6thSense-dev/mocap-glove/control-panel/README.txt

Run Start-control-panel.command to open localhost:8775.
Supports bench 0.1 and diagnostics 0.2. New tests require diagnostics 0.2.
Read ../START-HERE.txt before powered coil tests. No calibrated positions are produced.
