6thSense-dev/mocap-glove/hardware/pcb/v6/hand-hub/views/3d-bottom.png

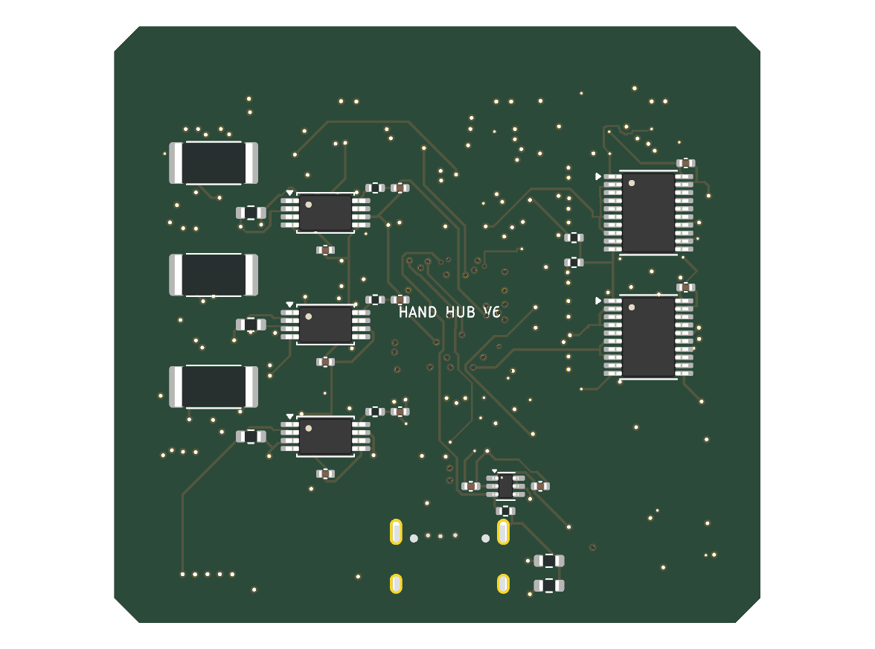
hardware/pcb/v6/hand-hub/views/3d-bottom.png
