6thSense-dev/mocap-glove/hardware/pcb/v6/source-carrier/views/3d-bottom.png

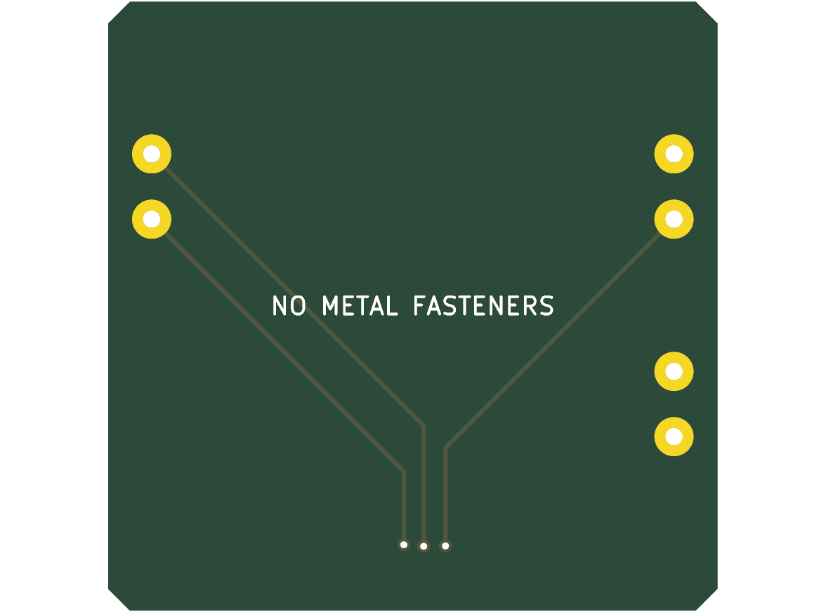
hardware/pcb/v6/source-carrier/views/3d-bottom.png
