6thSense-dev/mocap-glove/hardware/pcb/v6/fingertip/fabrication/BOM.csv

Comment | Designator | Footprint | LCSC Part #
ADS131M04IPWR | U1 | TSSOP-20_4.4x6.5mm_P0.65mm | C2862562
49.9 | R1,R10,R2,R5,R6,R9 | R_0402_1005Metric | C87044
10k | R11,R12,R3,R4,R7,R8 | R_0402_1005Metric | C25744
1n C0G | C1,C2,C3 | C_0402_1005Metric | C307441
10 | R13 | R_0402_1005Metric | C25077
1u | C4,C6 | C_0402_1005Metric | C52923
100n | C5,C7 | C_0402_1005Metric | C1525
220n | C8 | C_0402_1005Metric | C16772
33 | R14,R15 | R_0402_1005Metric | C25105
100k | R16,R17 | R_0402_1005Metric | C25741
4.7u | C9 | C_0402_1005Metric | C23733
