6thSense-dev/mocap-glove/hardware/pcb/v6/hand-hub/fabrication/BOM.csv

Comment | Designator | Footprint | LCSC Part #
TYPE-C-31-M-12 | J6 | USB_C_HRO_Envelope | C165948
5.1k | R1,R2 | R_0603_1608Metric | C23186
USBLC6-2SC6 | U2 | SOT-23-6 | C7519
TLV75533PDBVR | U3 | SOT-23-5 | C404027
1u | C1 | C_0603_1608Metric | C15849
4.7u | C2 | C_0603_1608Metric | C19666
0 | R3,R4 | R_0603_1608Metric | C21189
STM32G474RET6 | U1 | LQFP-64_10x10mm_P0.5mm | C521608
100n | C10,C11,C12,C13,C14,C15,C16,C19,C20,C23,C24,C27,C28,C29,C3,C4,C5,C6,C9 | C_0402_1005Metric | C1525
4.7u | C7 | C_0402_1005Metric | C23733
10 | R5 | R_0402_1005Metric | C25077
1u | C17,C21,C25,C8 | C_0402_1005Metric | C52923
10k | R52,R6 | R_0402_1005Metric | C25744
PH1.27-02-03PWS | J7 | XUNPU_PH127_2x03_SMD | C41360875
3N08192G33YC | Y1 | SJK_3N_3225 | C252332
33 | R25,R28,R31,R34,R37,R7 | R_0402_1005Metric | C25105
120 | R10,R11,R12,R13,R14,R15,R16,R17,R18,R19,R20,R21,R22,R8,R9 | R_0402_1005Metric | C114758
SN74LVC244APWR | U4,U5 | TSSOP-20_4.4x6.5mm_P0.65mm | C7668
FH12-12S-0.5SH(55) | J1,J2,J3,J4,J5 | Hirose_FH12-12S-0.5SH_1x12-1MP_P0.50mm_Horizontal | C88360
47 | R23,R24,R26,R27,R29,R30,R32,R33,R35,R36 | R_0402_1005Metric | C25118
100k | R38,R39,R51,R53 | R_0402_1005Metric | C25741
BMI323 | U6 | Bosch_LGA-14_3x2.5mm_P0.5mm | C5368700
4.7k | R40,R41 | R_0402_1005Metric | C25900
DRV8837DSGR | U7,U8,U9 | WSON-8-1EP_2x2mm_P0.5mm_EP0.9x1.6mm | C39159
FRR2512F47R0TS | R42,R45,R48 | R_2512_6332Metric | C49196864
RL0603FR-070R2L | R43,R46,R49 | R_0603_1608Metric | C723543
INA240A1PWR | U10,U11,U12 | TSSOP-8_4.4x3mm_P0.65mm | C93965
100 | R44,R47,R50 | R_0402_1005Metric | C25076
1nF C0G 50V | C18,C22,C26 | C_0402_1005Metric | C307441
BM06B-SRSS-TB(LF)(SN) | J9 | JST_SH_BM06B-SRSS-TB_1x06-1MP_P1.00mm_Vertical | C160392
B3U-1000P | SW1,SW2 | SW_SPST_B3U-1000P | C231329
TPS22919DCKR | U14 | SOT-363_SC-70-6 | C2149796
