6thSense-dev/mocap-glove/hardware/pcb/v6/source-carrier/fabrication/BOM.csv

Comment | Designator | Footprint | LCSC Part #
BM06B-SRSS-TB(LF)(SN) | J1 | JST_SH_BM06B-SRSS-TB_1x06-1MP_P1.00mm_Vertical | C160392
