6thSense-dev/mocap-glove/hardware/pcb/v6/fingertip/fingertip.kicad_pcb

## KiCad design hardware/pcb/v6/fingertip/fingertip.kicad_pcb (2026-11-04)

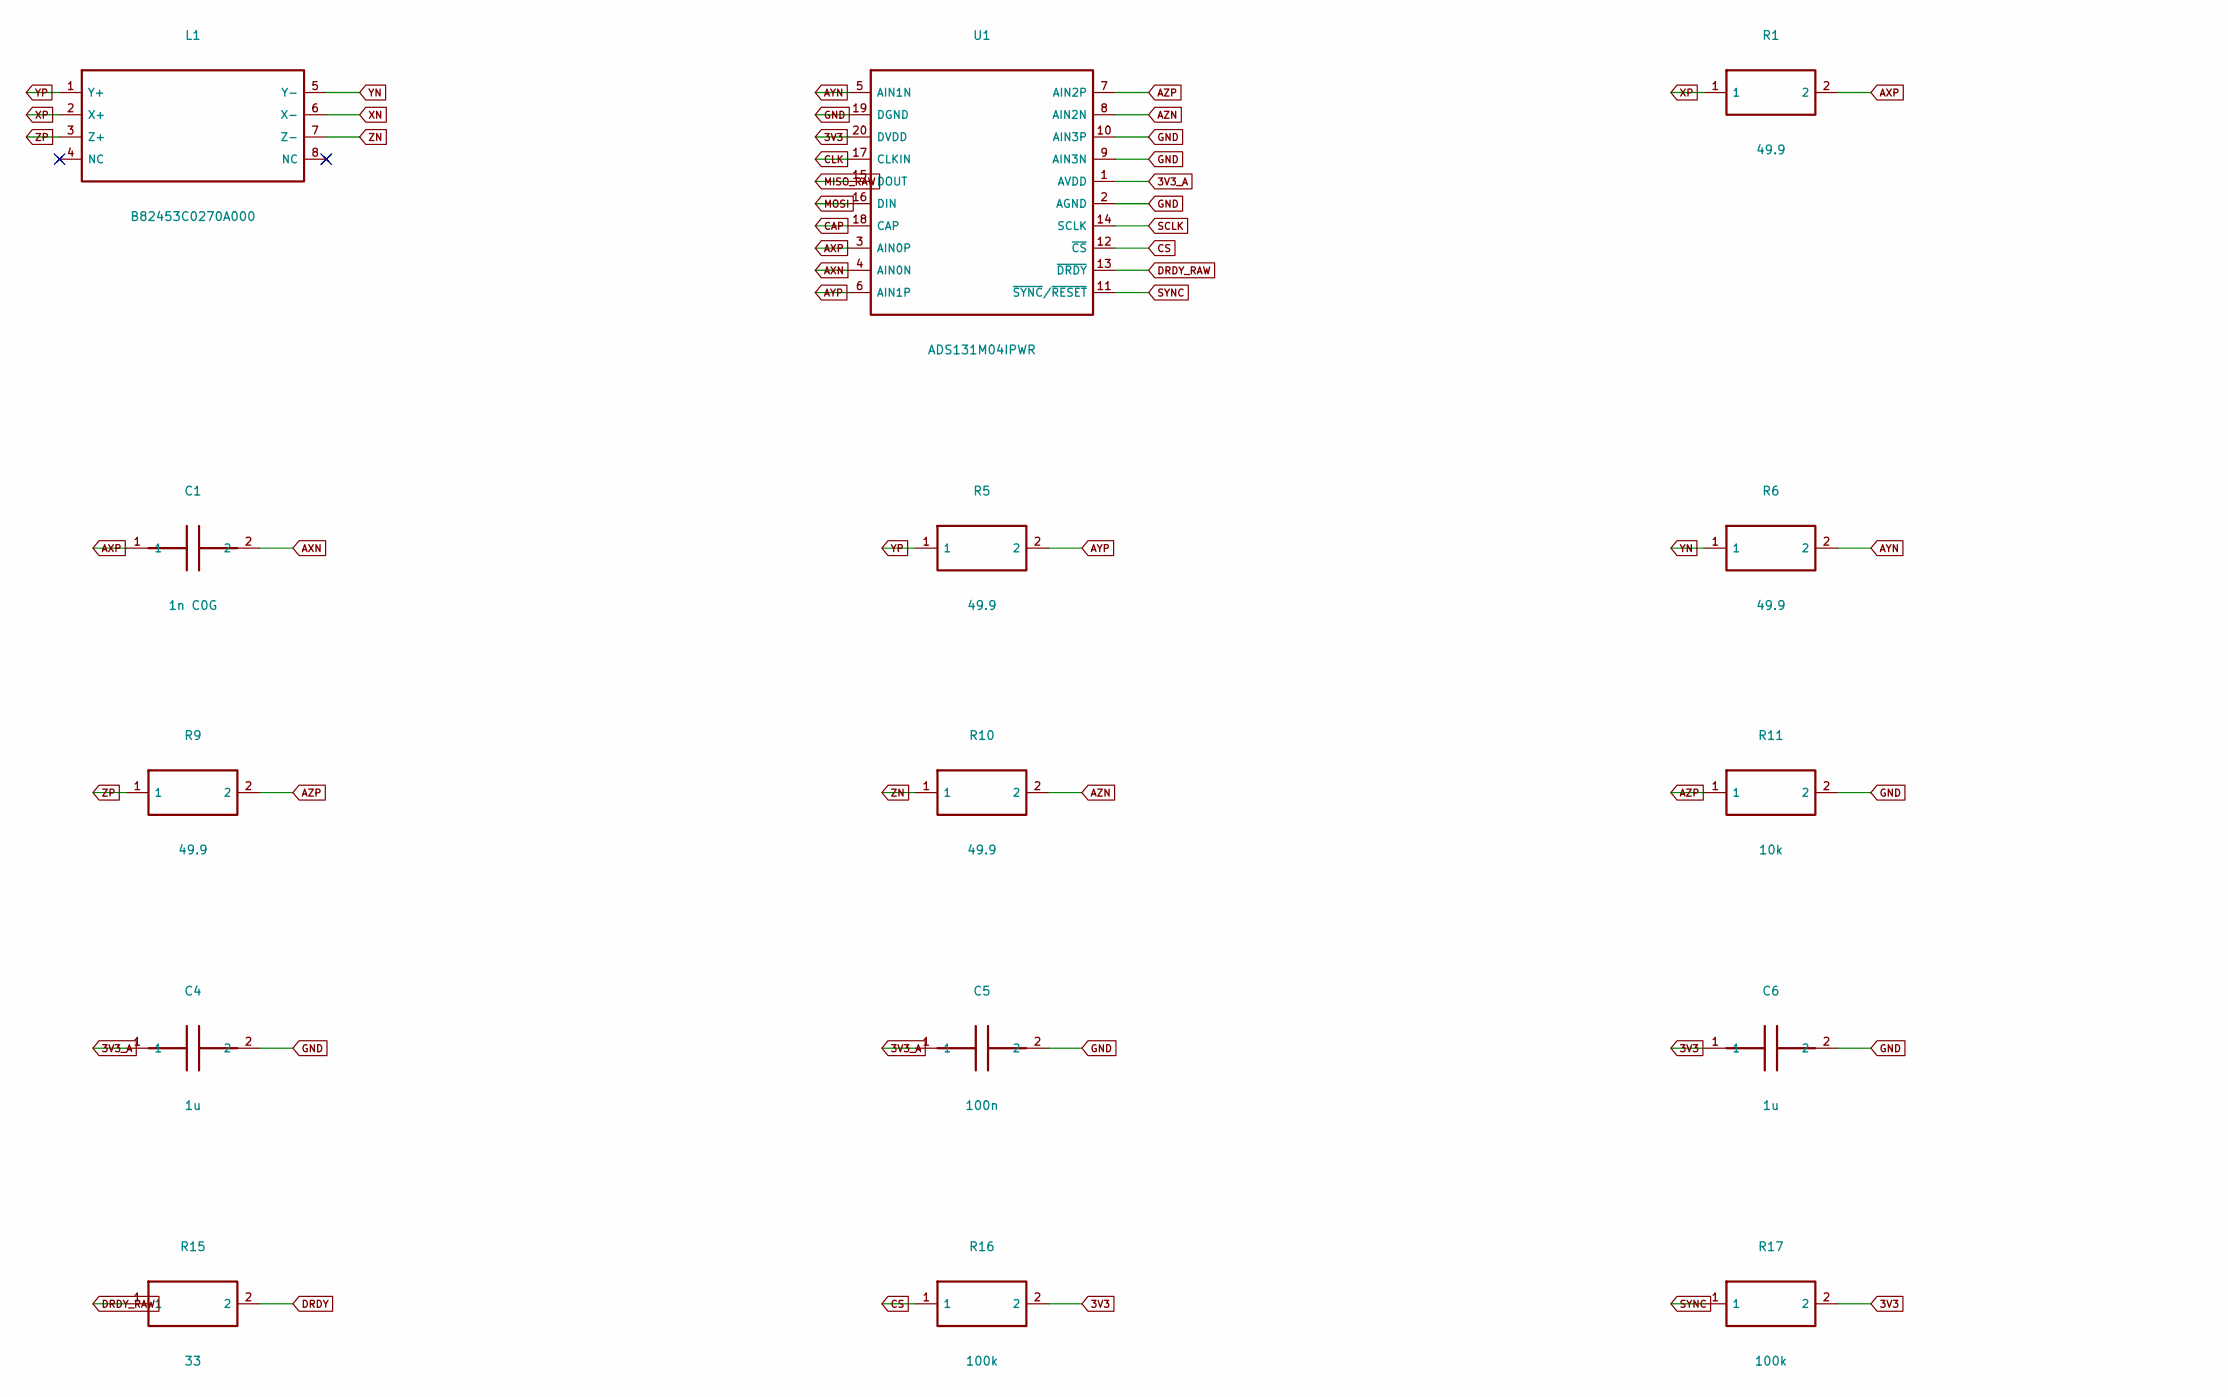
[picture p6: schematic sensor-and-adc.kicad_sch, fingertip - Sensor and ADC, part in row 1, column 1]

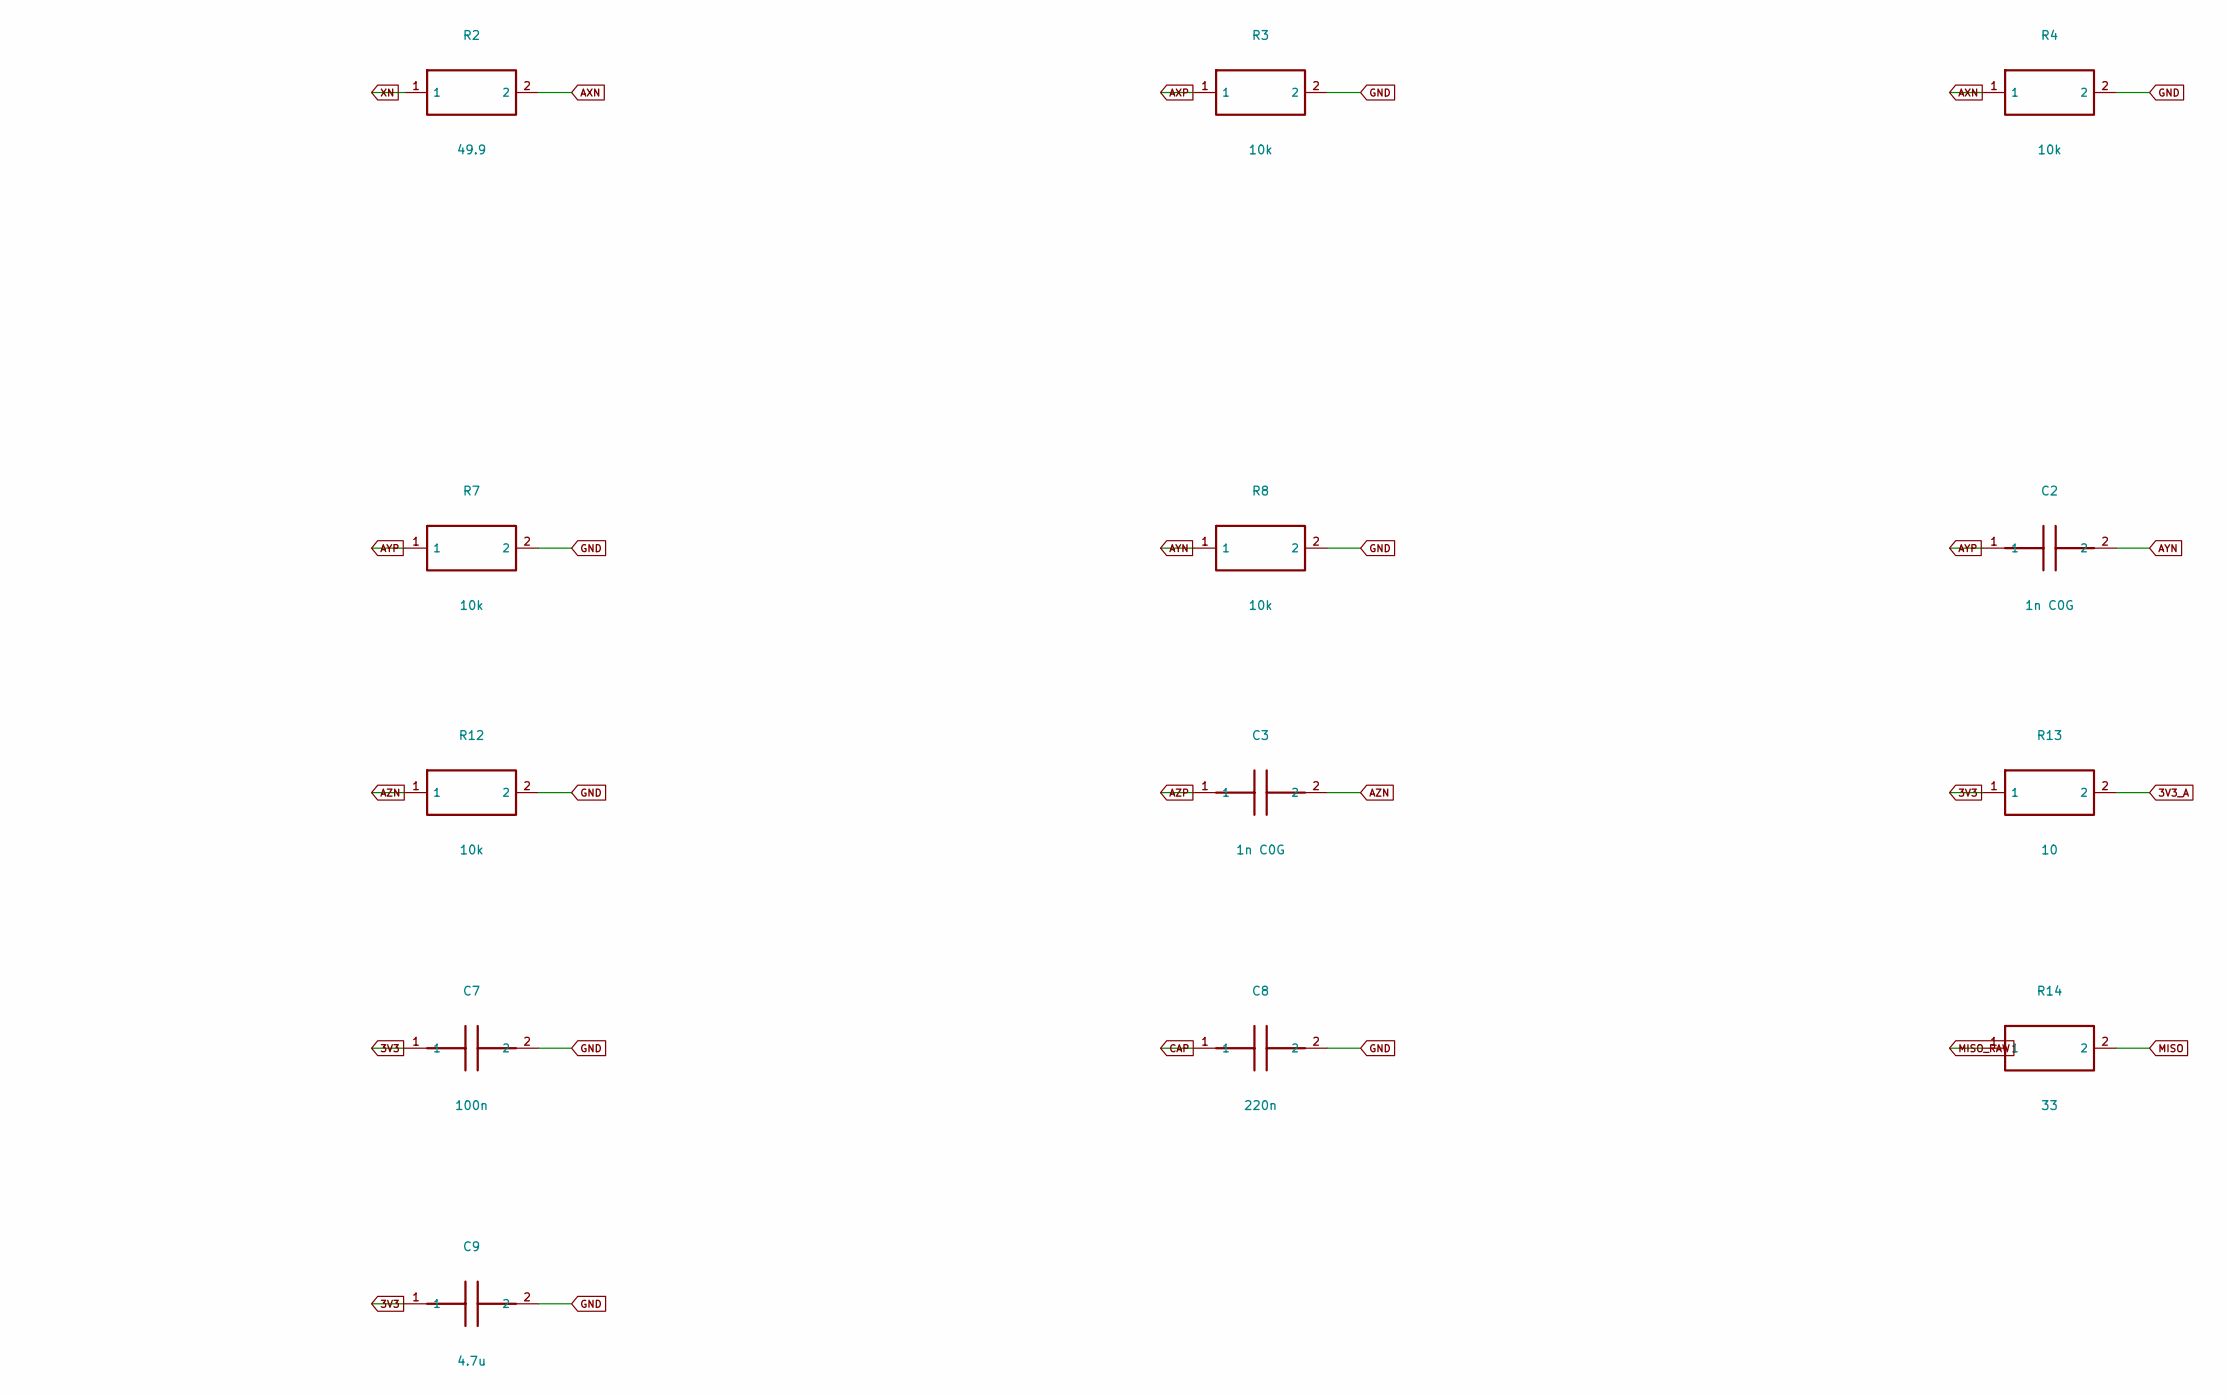
[picture p7: schematic sensor-and-adc.kicad_sch, fingertip - Sensor and ADC, part in row 1, column 2]

Parts:
C1, C2, C3: 1n C0G; C_0402_1005Metric; MPN 1n C0G
C4, C6: 1u; C_0402_1005Metric; MPN 1u
C5, C7: 100n; C_0402_1005Metric; MPN 100n
C8: 220n; C_0402_1005Metric; MPN 220n
C9: 4.7u; C_0402_1005Metric; MPN 4.7u
L1: B82453C0270A000; TDK_3D; MPN B82453C0270A000
R1, R2, R5, R6, R9, R10: 49.9; R_0402_1005Metric; MPN 49.9
R3, R4, R7, R8, R11, R12: 10k; R_0402_1005Metric; MPN 10k
R13: 10; R_0402_1005Metric; MPN 10
R14, R15: 33; R_0402_1005Metric; MPN 33
R16, R17: 100k; R_0402_1005Metric; MPN 100k
U1: ADS131M04IPWR; TSSOP-20_4.4x6.5mm_P0.65mm; MPN ADS131M04IPWR

Connections:
3V3: C6.1, C7.1, C9.1, R13.1, R16.2, R17.2, U1.20 (DVDD); also elsewhere on the board
3V3_A: C4.1, C5.1, R13.2, U1.1 (AVDD)
AXN: C1.2, R2.2, R4.1, U1.4 (AIN0N)
AXP: C1.1, R1.2, R3.1, U1.3 (AIN0P)
AYN: C2.2, R6.2, R8.1, U1.5 (AIN1N)
AYP: C2.1, R5.2, R7.1, U1.6 (AIN1P)
AZN: C3.2, R10.2, R12.1, U1.8 (AIN2N)
AZP: C3.1, R9.2, R11.1, U1.7 (AIN2P)
CAP: C8.1, U1.18 (CAP)
CLK: U1.17 (CLKIN); also elsewhere on the board
CS: R16.1, U1.12 (~CS); also elsewhere on the board
DRDY: R15.2; also elsewhere on the board
DRDY_RAW: R15.1, U1.13 (~DRDY)
GND: C4.2, C5.2, C6.2, C7.2, C8.2, C9.2, R3.2, R4.2, R7.2, R8.2, R11.2, R12.2, U1.2 (AGND), U1.9 (AIN3N), U1.10 (AIN3P), U1.19 (DGND); also elsewhere on the board
MISO: R14.2; also elsewhere on the board
MISO_RAW: R14.1, U1.15 (DOUT)
MOSI: U1.16 (DIN); also elsewhere on the board
SCLK: U1.14 (SCLK); also elsewhere on the board
SYNC: R17.1, U1.11 (~SYNC/~RESET); also elsewhere on the board
XN: L1.6 (X-), R2.1
XP: L1.2 (X+), R1.1
YN: L1.5 (Y-), R6.1
YP: L1.1 (Y+), R5.1
ZN: L1.7 (Z-), R10.1
ZP: L1.3 (Z+), R9.1

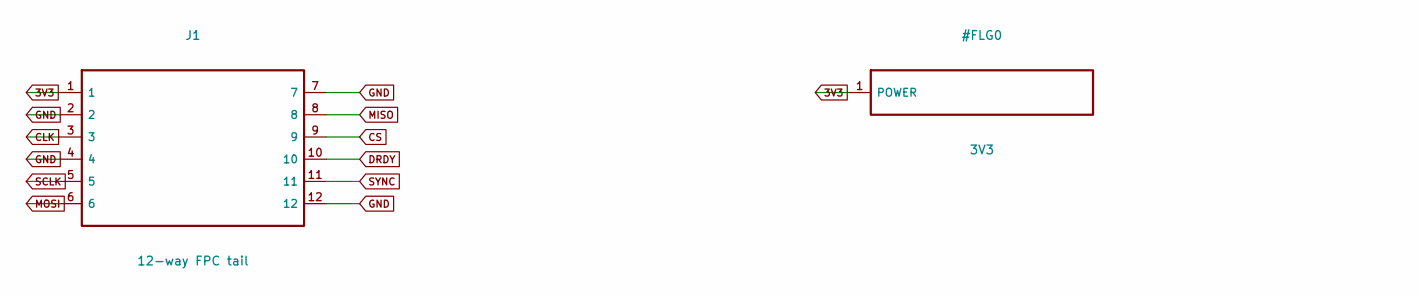
[picture p8: schematic power-and-data-flex.kicad_sch, fingertip - Power and data flex, part in row 1, column 1]

Parts:
J1: 12-way FPC tail; Tail12; MPN 12-way FPC tail

Connections:
3V3: J1.1; also elsewhere on the board
CLK: J1.3; also elsewhere on the board
CS: J1.9; also elsewhere on the board
DRDY: J1.10; also elsewhere on the board
GND: J1.2, J1.4, J1.7, J1.12; also elsewhere on the board
MISO: J1.8; also elsewhere on the board
MOSI: J1.6; also elsewhere on the board
SCLK: J1.5; also elsewhere on the board
SYNC: J1.11; also elsewhere on the board

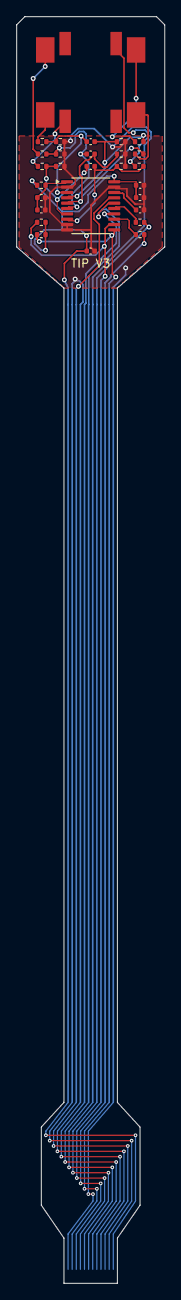
[picture p9: board fingertip.kicad_pcb from above]

Board: 2 copper layers, 18.0 x 154.0 mm, 29 parts (0 on the bottom side), 25 nets.
