6thSense-dev/mocap-glove/hardware/pcb/v6/hand-hub/hand-hub.kicad_pcb

## KiCad design hardware/pcb/v6/hand-hub/hand-hub.kicad_pcb (2026-11-04)

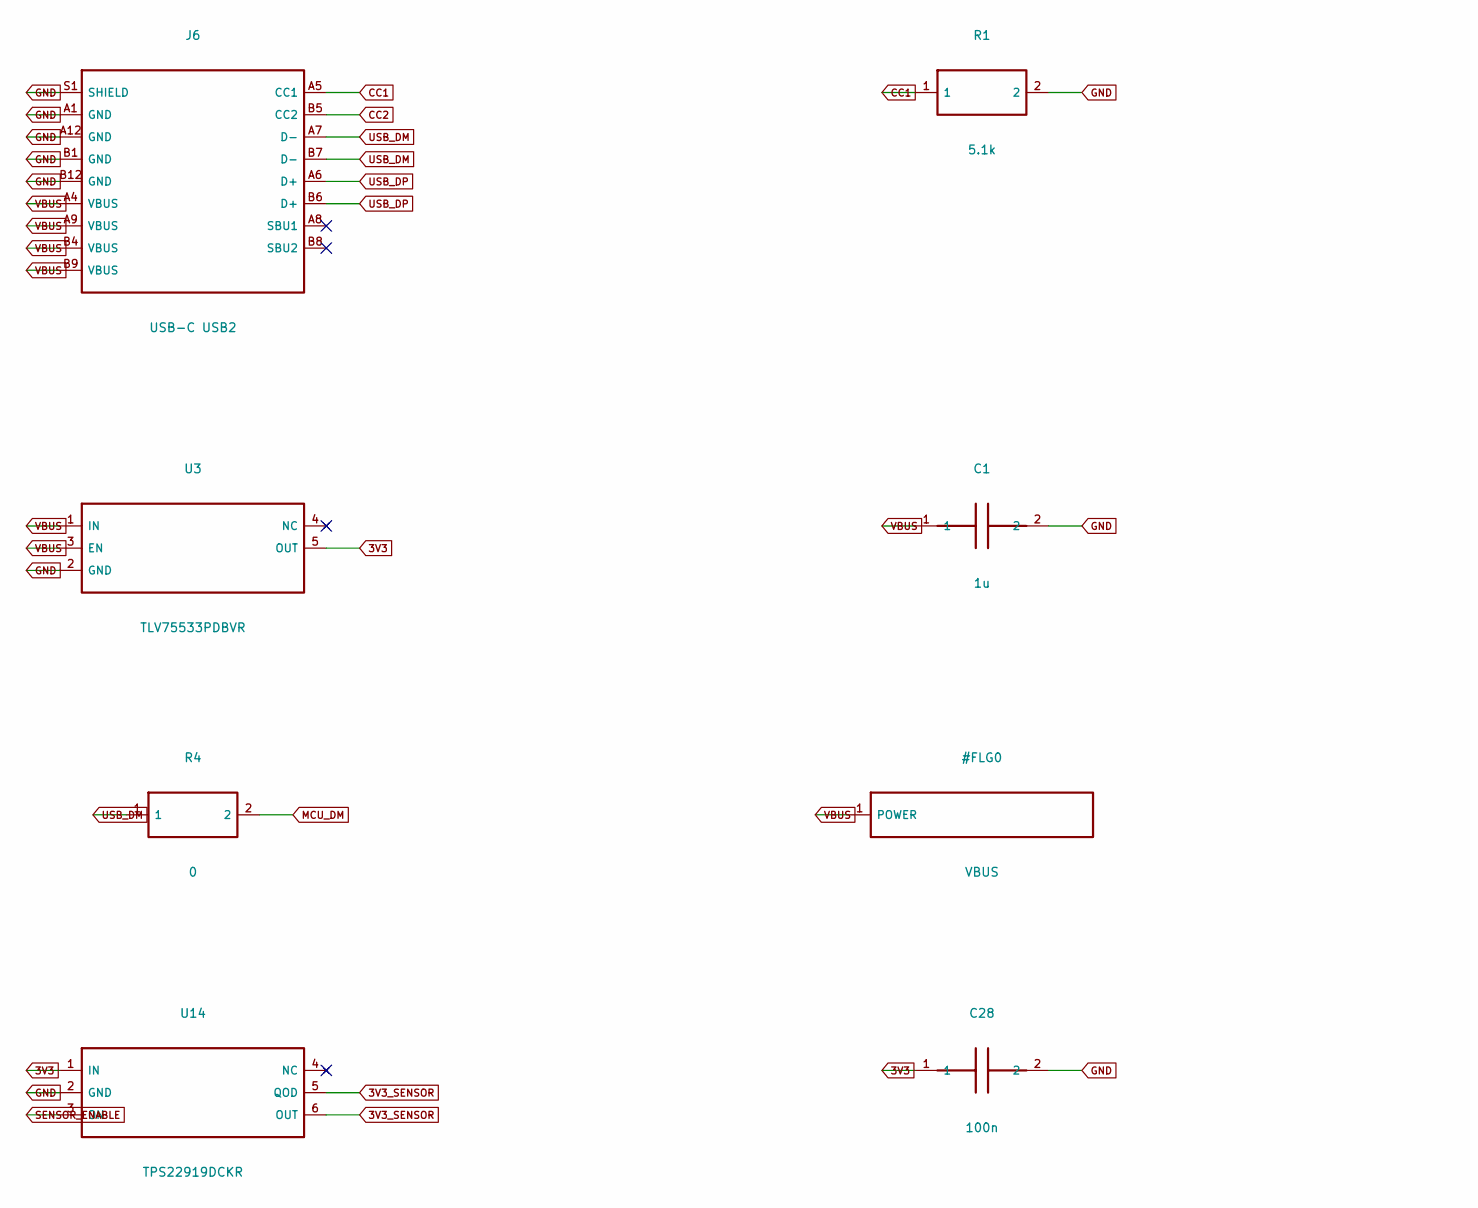
[picture p10: schematic power-usb.kicad_sch, hand-hub - Power USB, part in row 1, column 1]

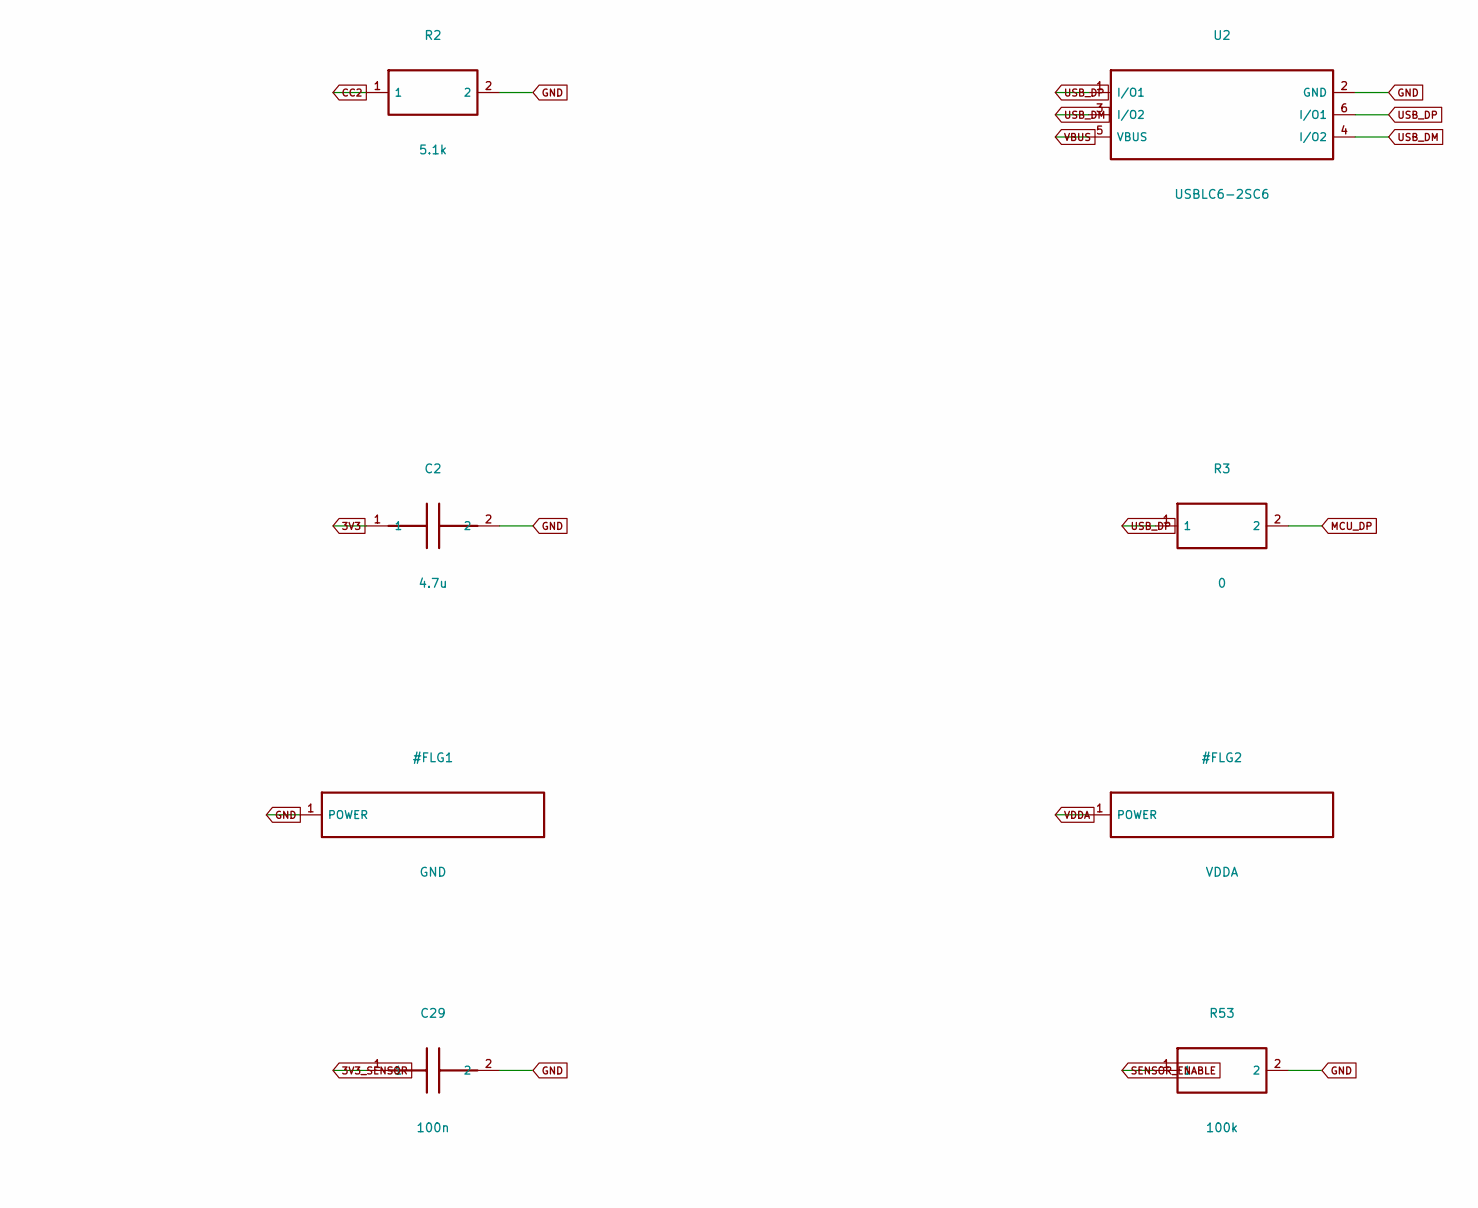
[picture p11: schematic power-usb.kicad_sch, hand-hub - Power USB, part in row 1, column 2]

Parts:
C1: 1u; C_0603_1608Metric; MPN 1u
C2: 4.7u; C_0603_1608Metric; MPN 4.7u
C28, C29: 100n; C_0402_1005Metric; MPN 100n
J6: USB-C USB2; USB_C_HRO_Envelope; MPN TYPE-C-31-M-12
R1, R2: 5.1k; R_0603_1608Metric; MPN 5.1k
R3, R4: 0; R_0603_1608Metric; MPN 0603WAF0000T5E
R53: 100k; R_0402_1005Metric; MPN 100k
U2: USBLC6-2SC6; SOT-23-6; MPN USBLC6-2SC6
U3: TLV75533PDBVR; SOT-23-5; MPN TLV75533PDBVR
U14: TPS22919DCKR; SOT-363_SC-70-6; MPN TPS22919DCKR

Connections:
3V3: C2.1, C28.1, U3.5 (OUT), U14.1 (IN); also elsewhere on the board
3V3_SENSOR: C29.1, U14.5 (QOD), U14.6 (OUT); also elsewhere on the board
CC1: J6.A5 (CC1), R1.1
CC2: J6.B5 (CC2), R2.1
GND: C1.2, C2.2, C28.2, C29.2, J6.A1 (GND), J6.A12 (GND), J6.B1 (GND), J6.B12 (GND), J6.S1 (SHIELD), R1.2, R2.2, R53.2, U2.2 (GND), U3.2 (GND), U14.2 (GND); also elsewhere on the board
MCU_DM: R4.2; also elsewhere on the board
MCU_DP: R3.2; also elsewhere on the board
SENSOR_ENABLE: R53.1, U14.3 (ON); also elsewhere on the board
USB_DM: J6.A7 (D-), J6.B7 (D-), R4.1, U2.3 (I/O2), U2.4 (I/O2)
USB_DP: J6.A6 (D+), J6.B6 (D+), R3.1, U2.1 (I/O1), U2.6 (I/O1)
VBUS: C1.1, J6.A4 (VBUS), J6.A9 (VBUS), J6.B4 (VBUS), J6.B9 (VBUS), U2.5 (VBUS), U3.1 (IN), U3.3 (EN); also elsewhere on the board

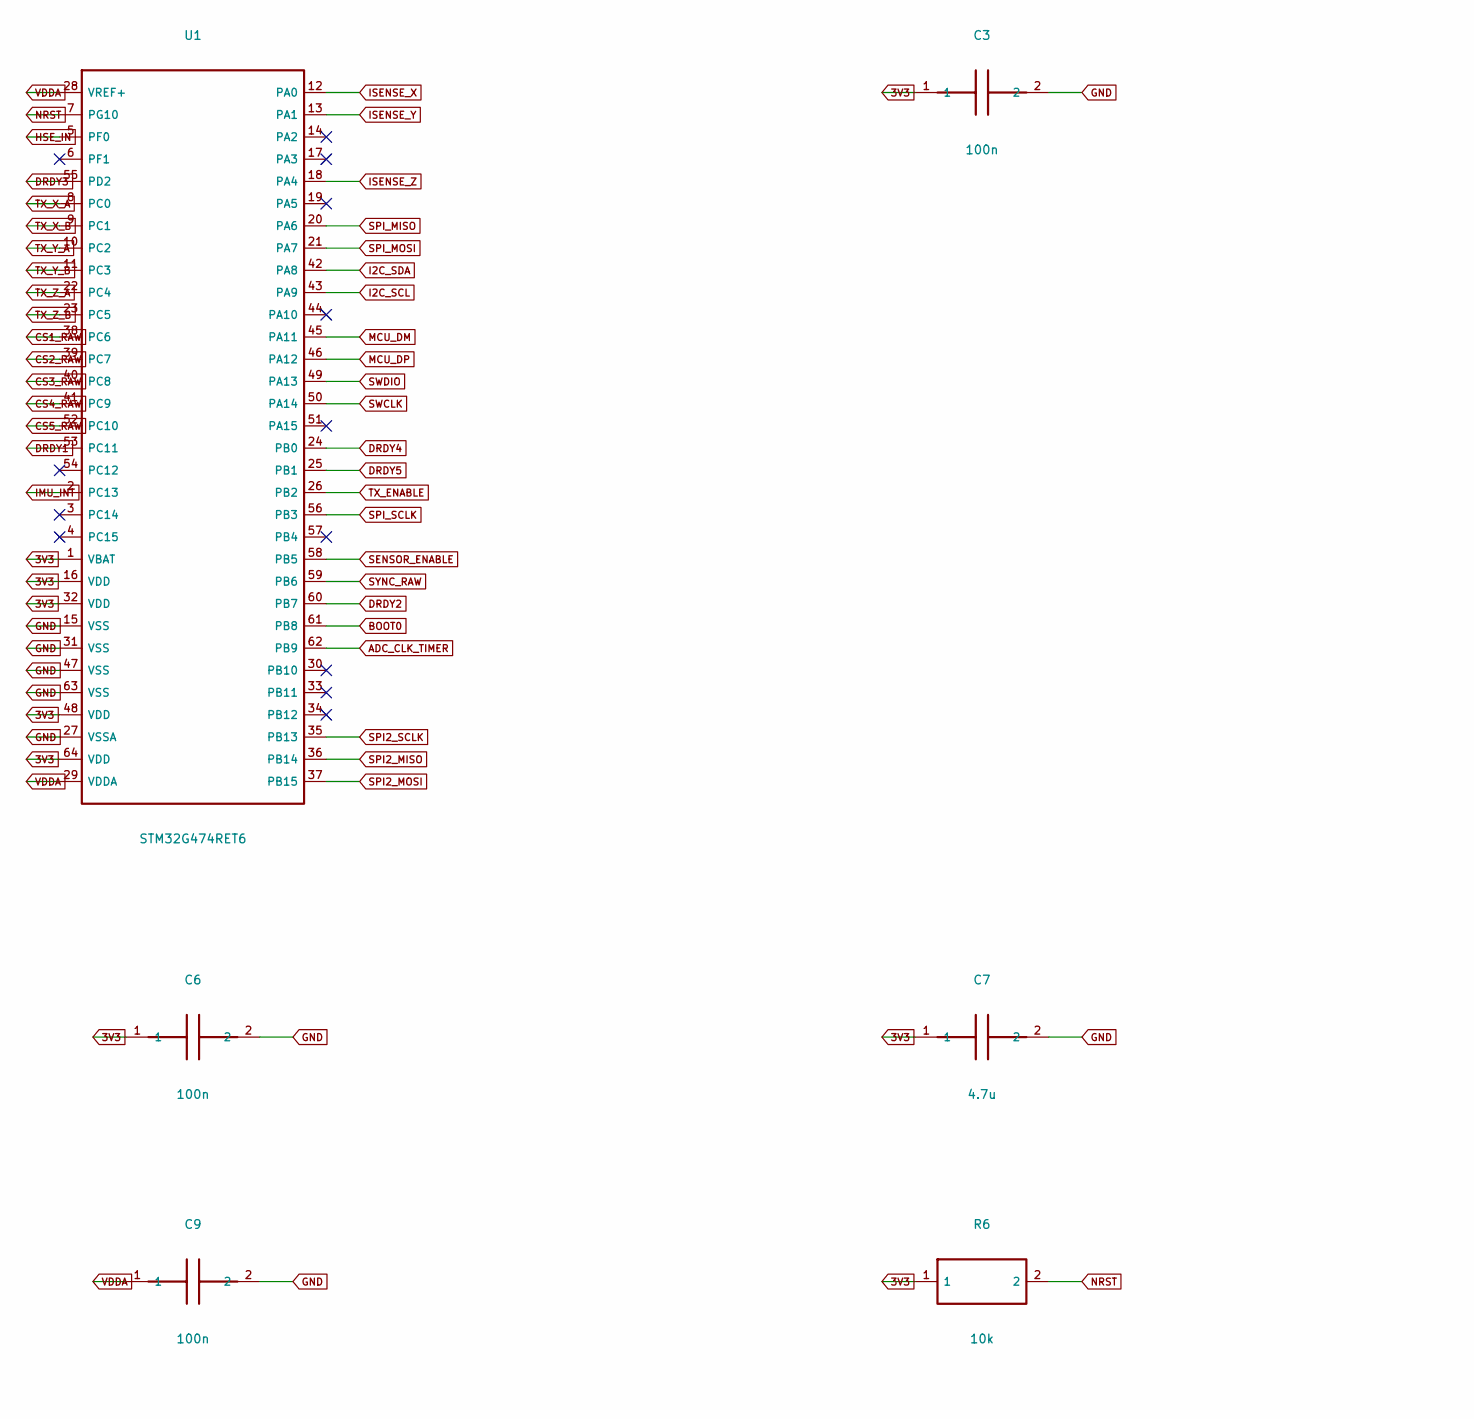
[picture p12: schematic controller.kicad_sch, hand-hub - Controller, part in row 1, column 1]

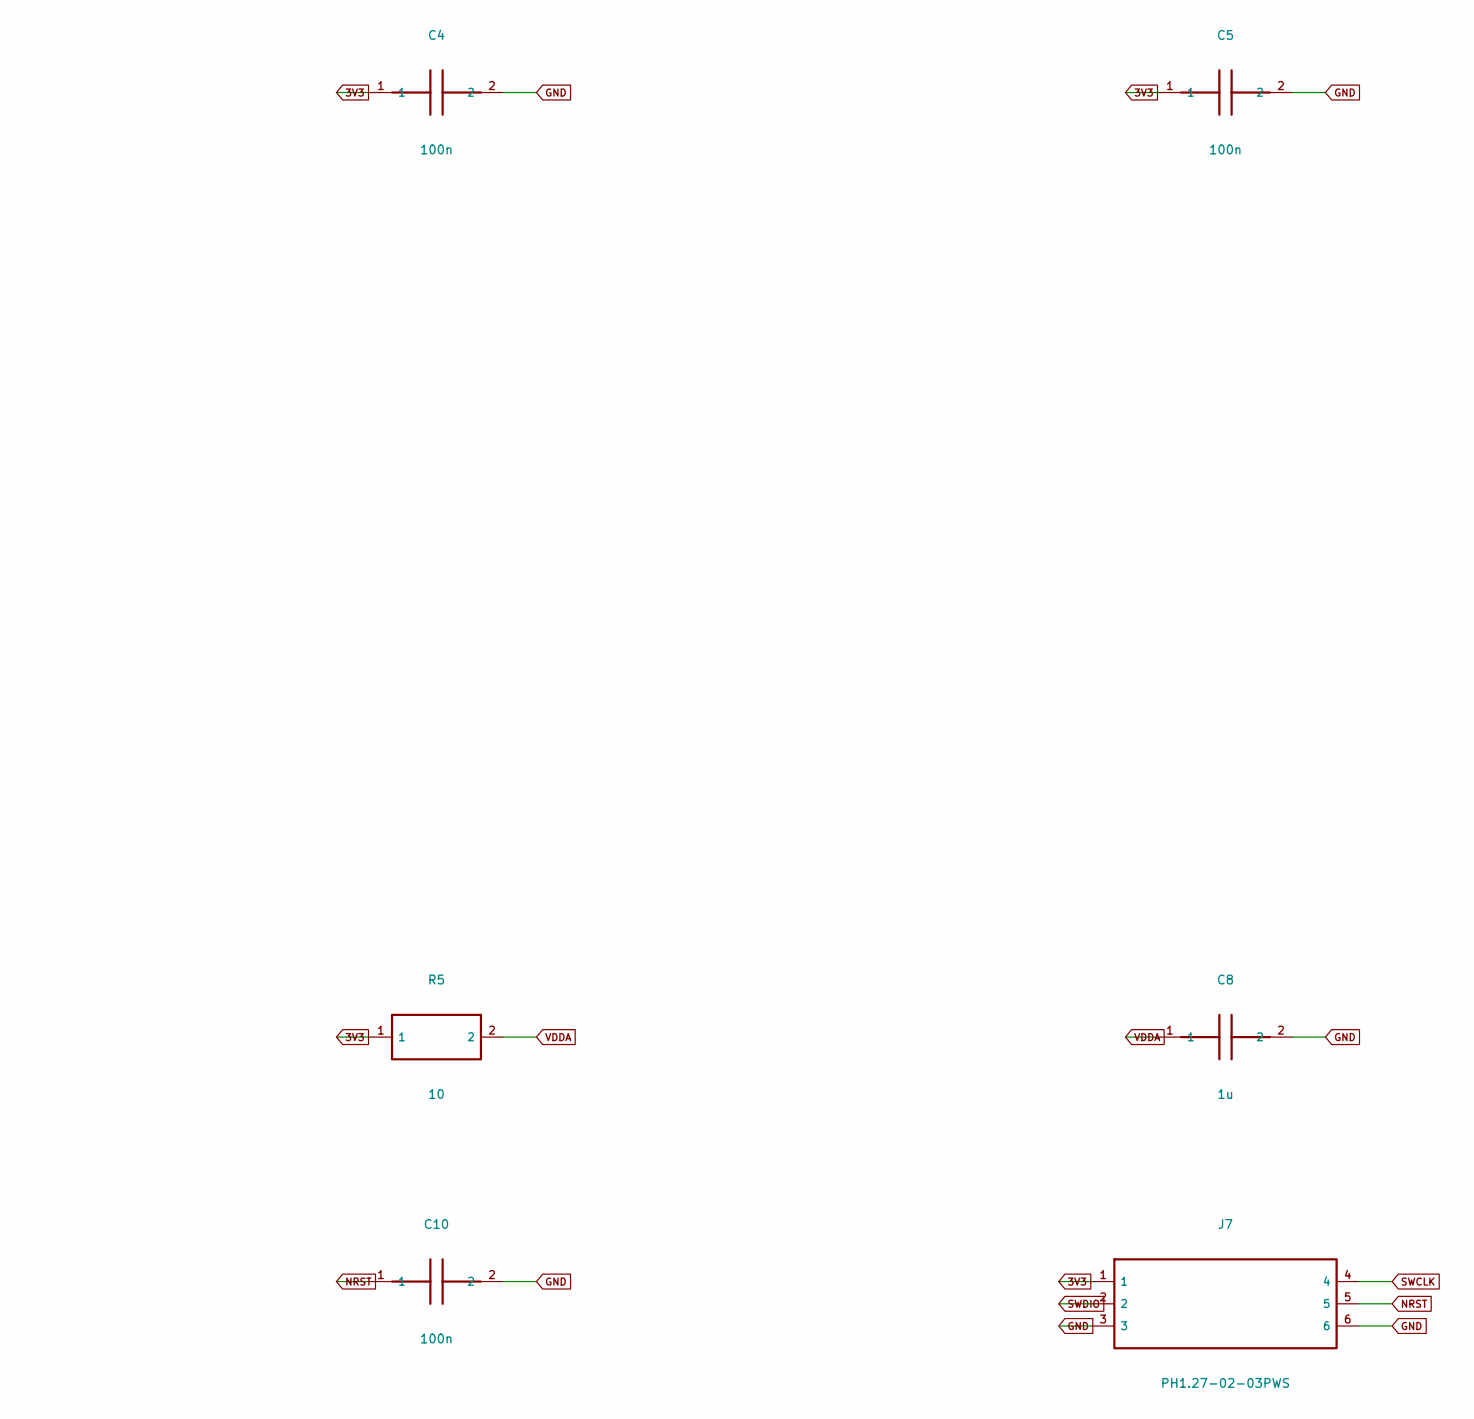
[picture p13: schematic controller.kicad_sch, hand-hub - Controller, part in row 1, column 2]

Parts:
C3, C4, C5, C6, C9, C10: 100n; C_0402_1005Metric; MPN 100n
C7: 4.7u; C_0402_1005Metric; MPN 4.7u
C8: 1u; C_0402_1005Metric; MPN 1u
J7: PH1.27-02-03PWS; XUNPU_PH127_2x03_SMD; MPN PH1.27-02-03PWS
R5: 10; R_0402_1005Metric; MPN 10
R6: 10k; R_0402_1005Metric; MPN 10k
U1: STM32G474RET6; LQFP-64_10x10mm_P0.5mm; MPN STM32G474RET6

Connections:
3V3: C3.1, C4.1, C5.1, C6.1, C7.1, J7.1, R5.1, R6.1, U1.1 (VBAT), U1.16 (VDD), U1.32 (VDD), U1.48 (VDD), U1.64 (VDD); also elsewhere on the board
ADC_CLK_TIMER: U1.62 (PB9); also elsewhere on the board
BOOT0: U1.61 (PB8); also elsewhere on the board
CS1_RAW: U1.38 (PC6); also elsewhere on the board
CS2_RAW: U1.39 (PC7); also elsewhere on the board
CS3_RAW: U1.40 (PC8); also elsewhere on the board
CS4_RAW: U1.41 (PC9); also elsewhere on the board
CS5_RAW: U1.52 (PC10); also elsewhere on the board
DRDY1: U1.53 (PC11); also elsewhere on the board
DRDY2: U1.60 (PB7); also elsewhere on the board
DRDY3: U1.55 (PD2); also elsewhere on the board
DRDY4: U1.24 (PB0); also elsewhere on the board
DRDY5: U1.25 (PB1); also elsewhere on the board
GND: C3.2, C4.2, C5.2, C6.2, C7.2, C8.2, C9.2, C10.2, J7.3, J7.6, U1.15 (VSS), U1.27 (VSSA), U1.31 (VSS), U1.47 (VSS), U1.63 (VSS); also elsewhere on the board
HSE_IN: U1.5 (PF0); also elsewhere on the board
I2C_SCL: U1.43 (PA9); also elsewhere on the board
I2C_SDA: U1.42 (PA8); also elsewhere on the board
IMU_INT: U1.2 (PC13); also elsewhere on the board
ISENSE_X: U1.12 (PA0); also elsewhere on the board
ISENSE_Y: U1.13 (PA1); also elsewhere on the board
ISENSE_Z: U1.18 (PA4); also elsewhere on the board
MCU_DM: U1.45 (PA11); also elsewhere on the board
MCU_DP: U1.46 (PA12); also elsewhere on the board
NRST: C10.1, J7.5, R6.2, U1.7 (PG10); also elsewhere on the board
SENSOR_ENABLE: U1.58 (PB5); also elsewhere on the board
SPI2_MISO: U1.36 (PB14); also elsewhere on the board
SPI2_MOSI: U1.37 (PB15); also elsewhere on the board
SPI2_SCLK: U1.35 (PB13); also elsewhere on the board
SPI_MISO: U1.20 (PA6); also elsewhere on the board
SPI_MOSI: U1.21 (PA7); also elsewhere on the board
SPI_SCLK: U1.56 (PB3); also elsewhere on the board
SWCLK: J7.4, U1.50 (PA14)
SWDIO: J7.2, U1.49 (PA13)
SYNC_RAW: U1.59 (PB6); also elsewhere on the board
TX_ENABLE: U1.26 (PB2); also elsewhere on the board
TX_X_A: U1.8 (PC0); also elsewhere on the board
TX_X_B: U1.9 (PC1); also elsewhere on the board
TX_Y_A: U1.10 (PC2); also elsewhere on the board
TX_Y_B: U1.11 (PC3); also elsewhere on the board
TX_Z_A: U1.22 (PC4); also elsewhere on the board
TX_Z_B: U1.23 (PC5); also elsewhere on the board
VDDA: C8.1, C9.1, R5.2, U1.28 (VREF+), U1.29 (VDDA)
