6thSense-dev/mocap-glove/hardware/pcb/v6/hand-hub/hand-hub.kicad_pcb

## KiCad design hardware/pcb/v6/hand-hub/hand-hub.kicad_pcb (continued)

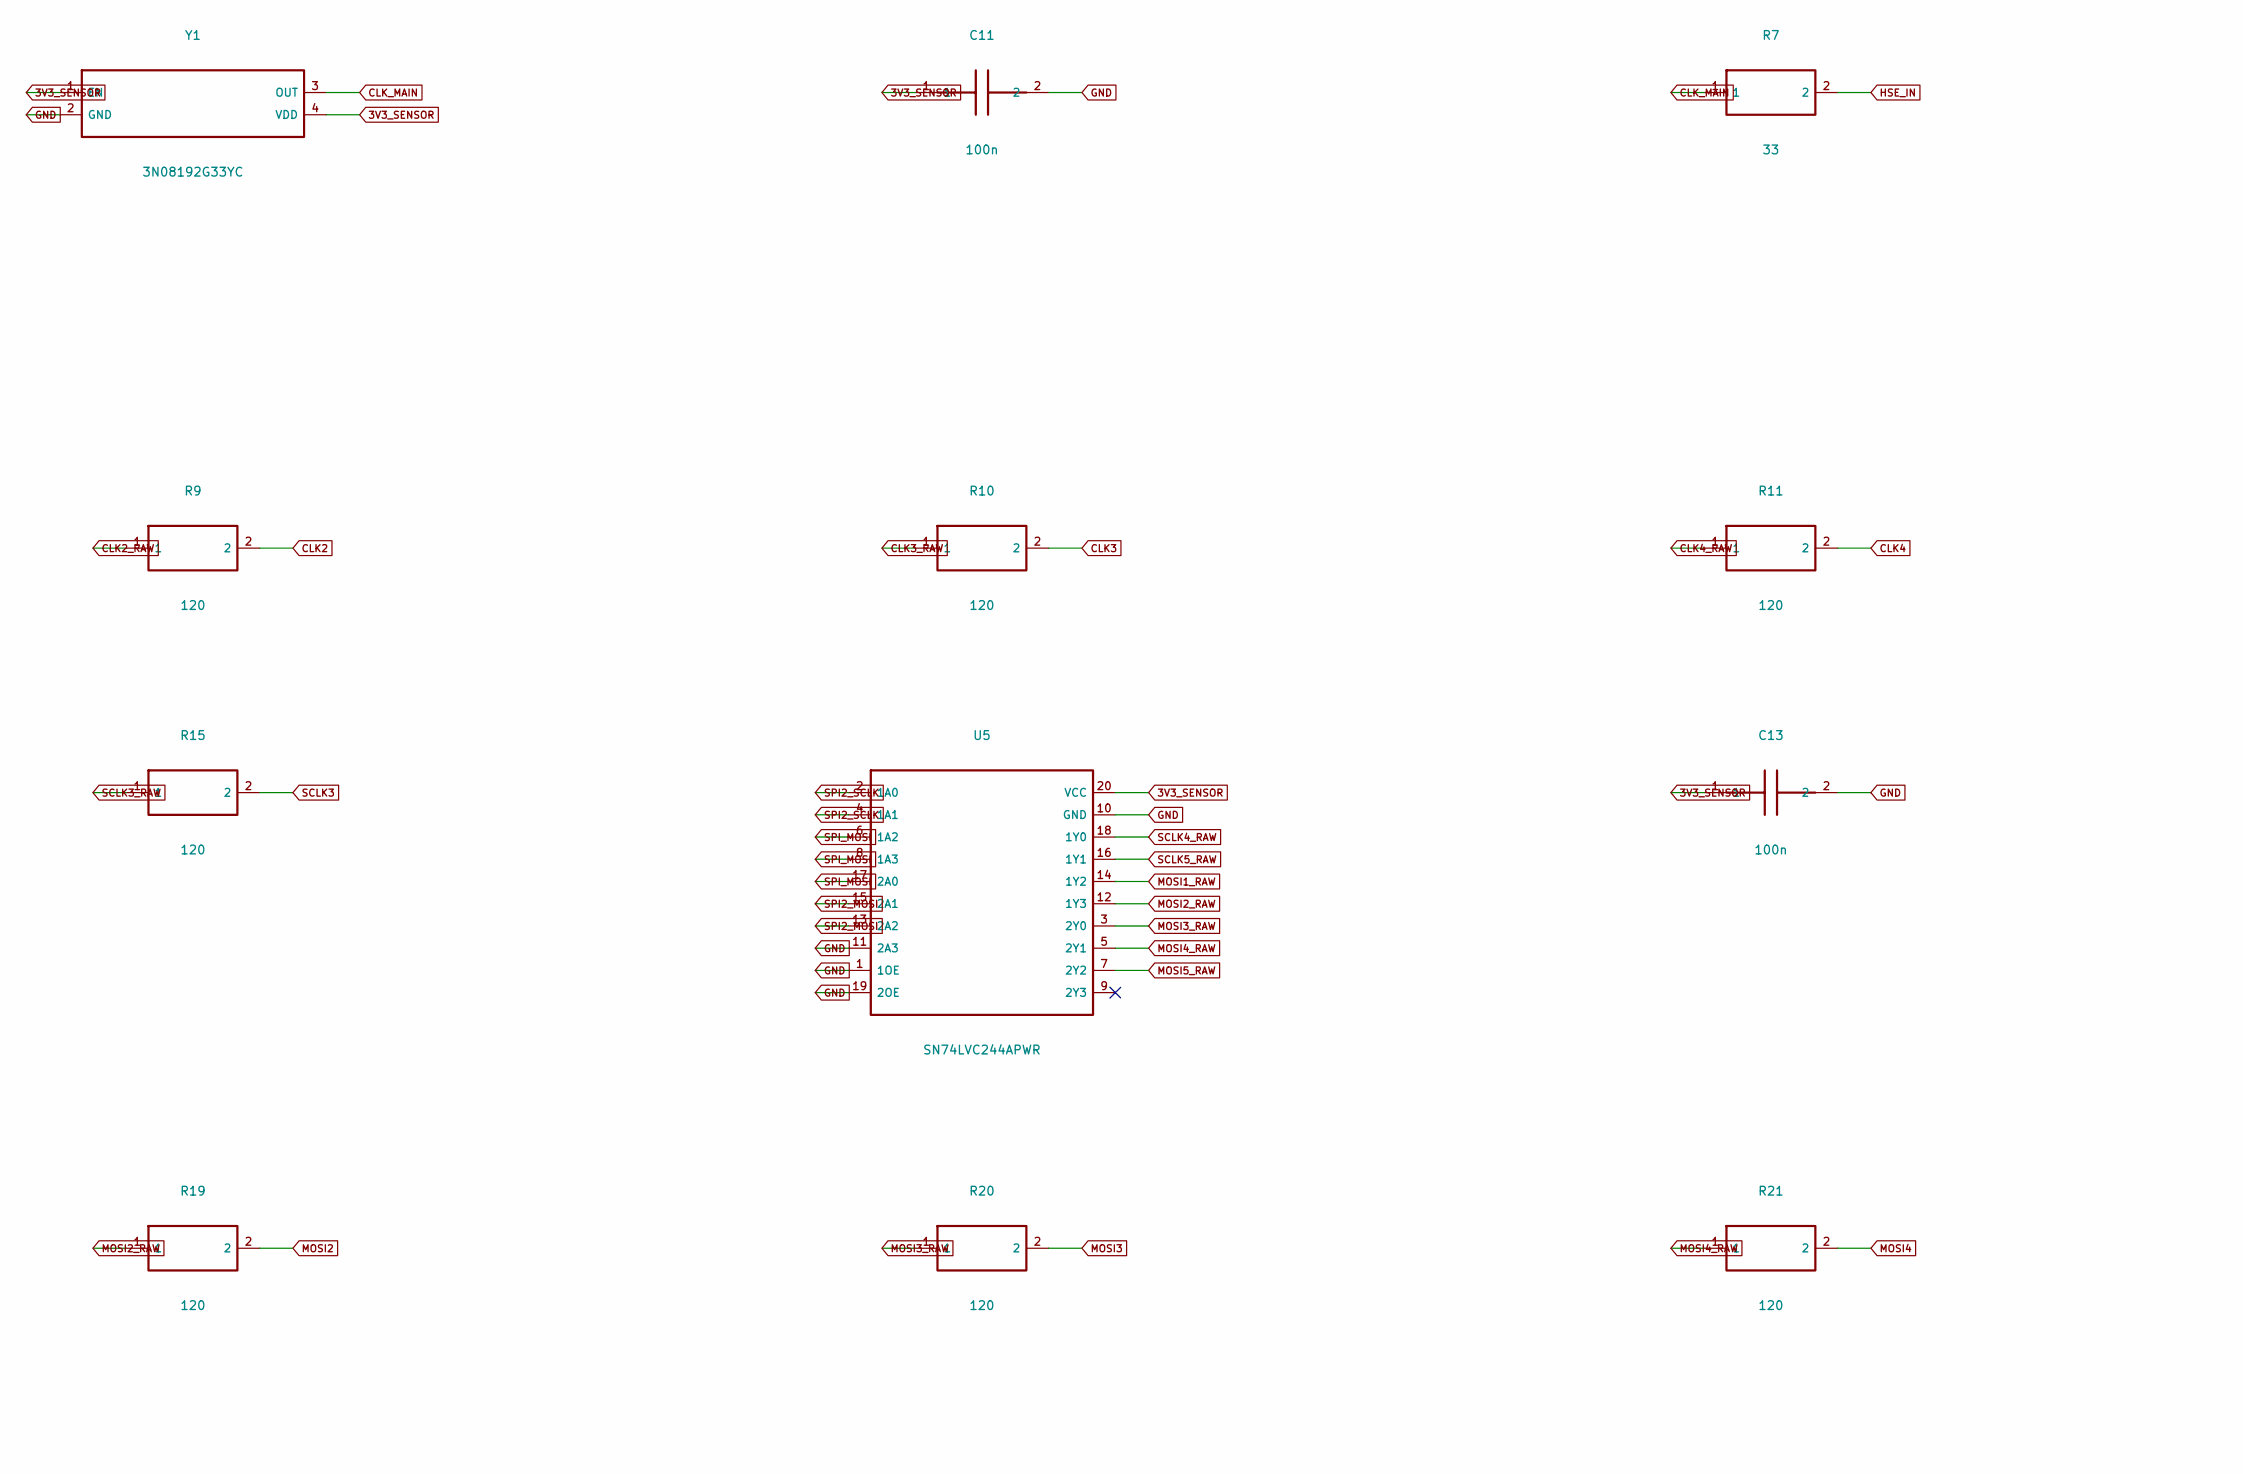
[picture p14: schematic finger-interfaces.kicad_sch, hand-hub - Finger Interfaces, part in row 1, column 1]

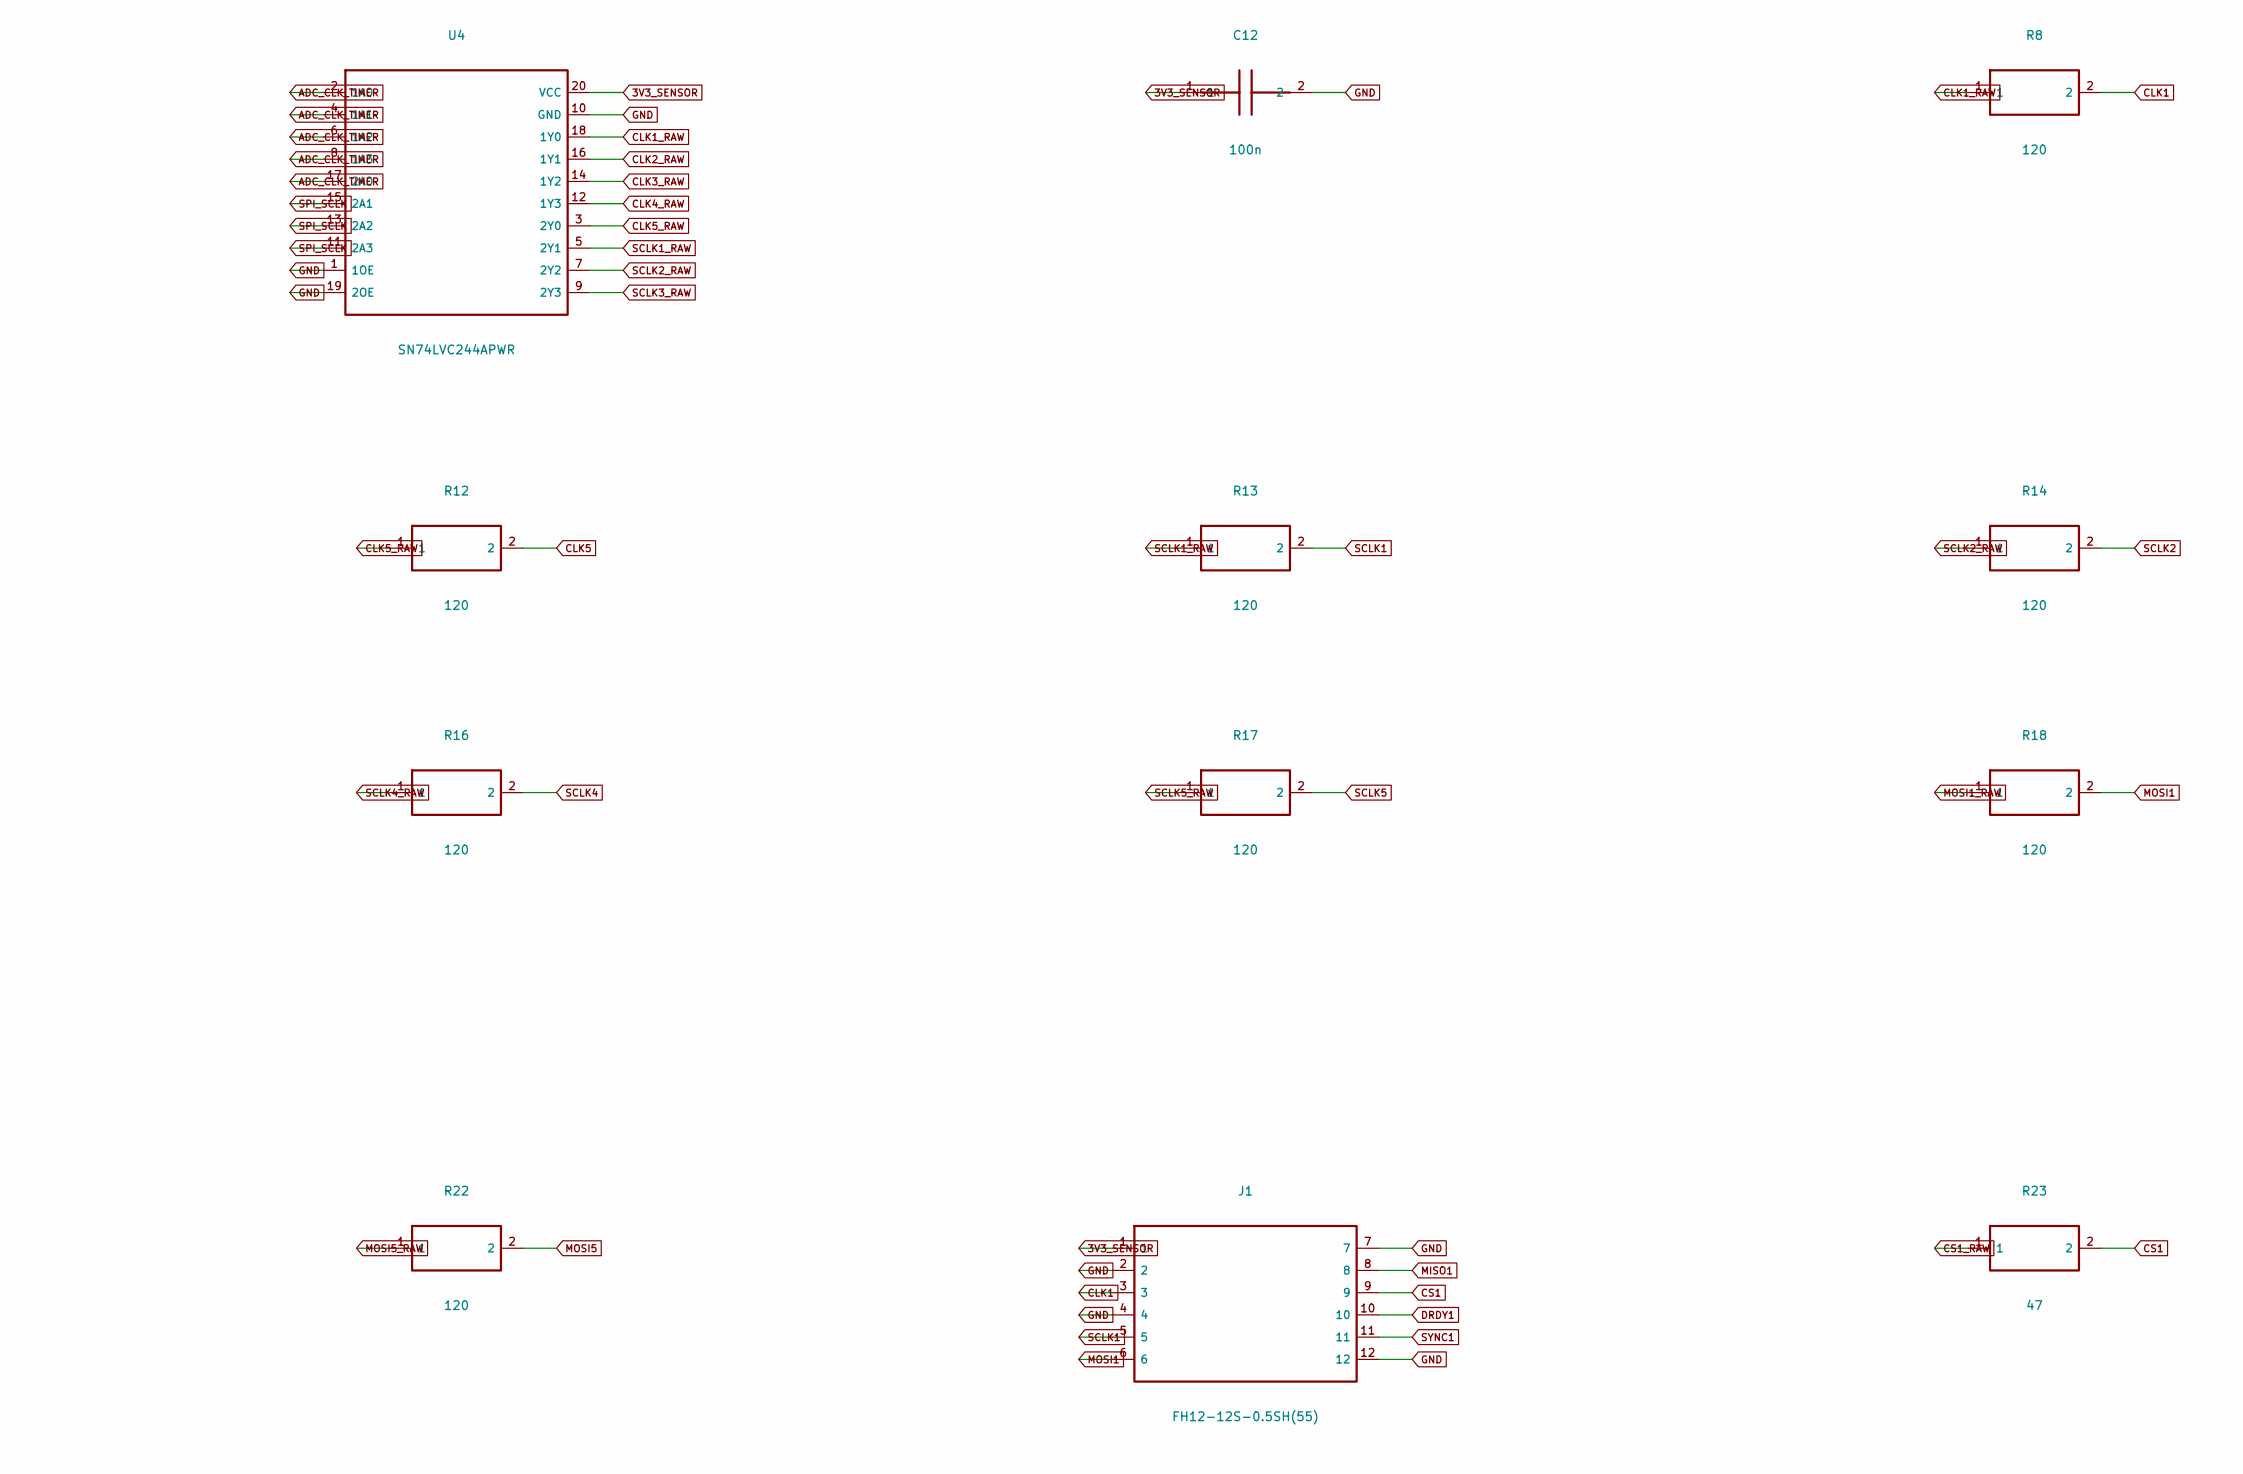
[picture p15: schematic finger-interfaces.kicad_sch, hand-hub - Finger Interfaces, part in row 1, column 2]

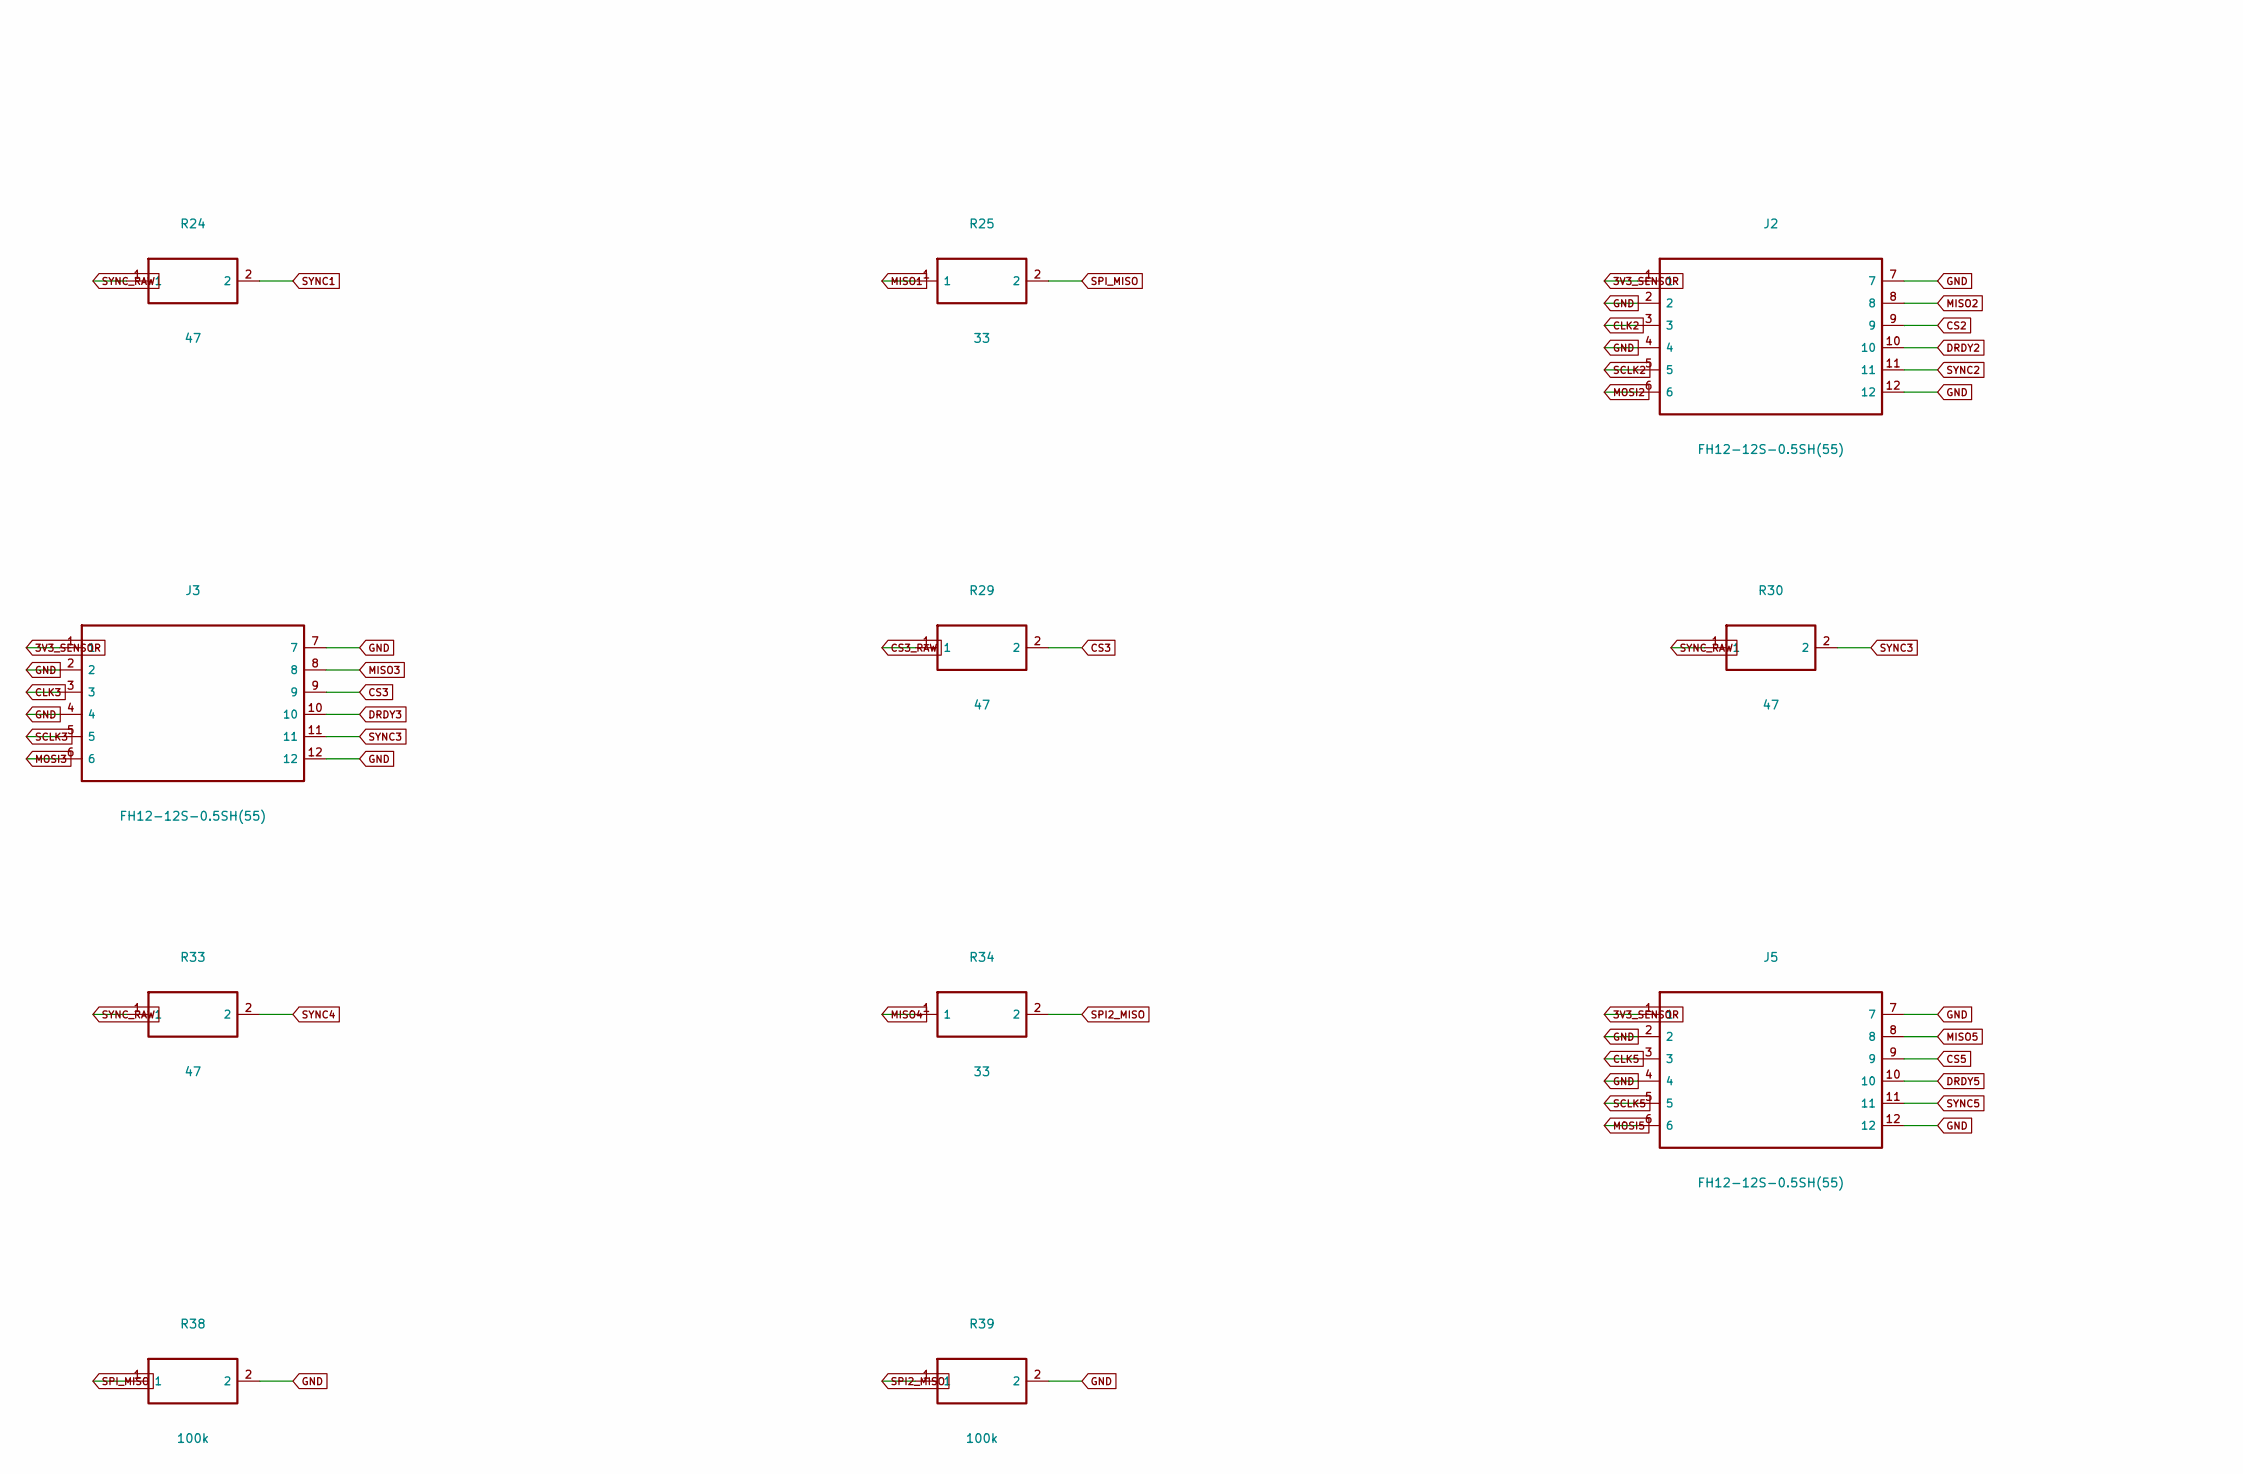
[picture p16: schematic finger-interfaces.kicad_sch, hand-hub - Finger Interfaces, part in row 2, column 1]

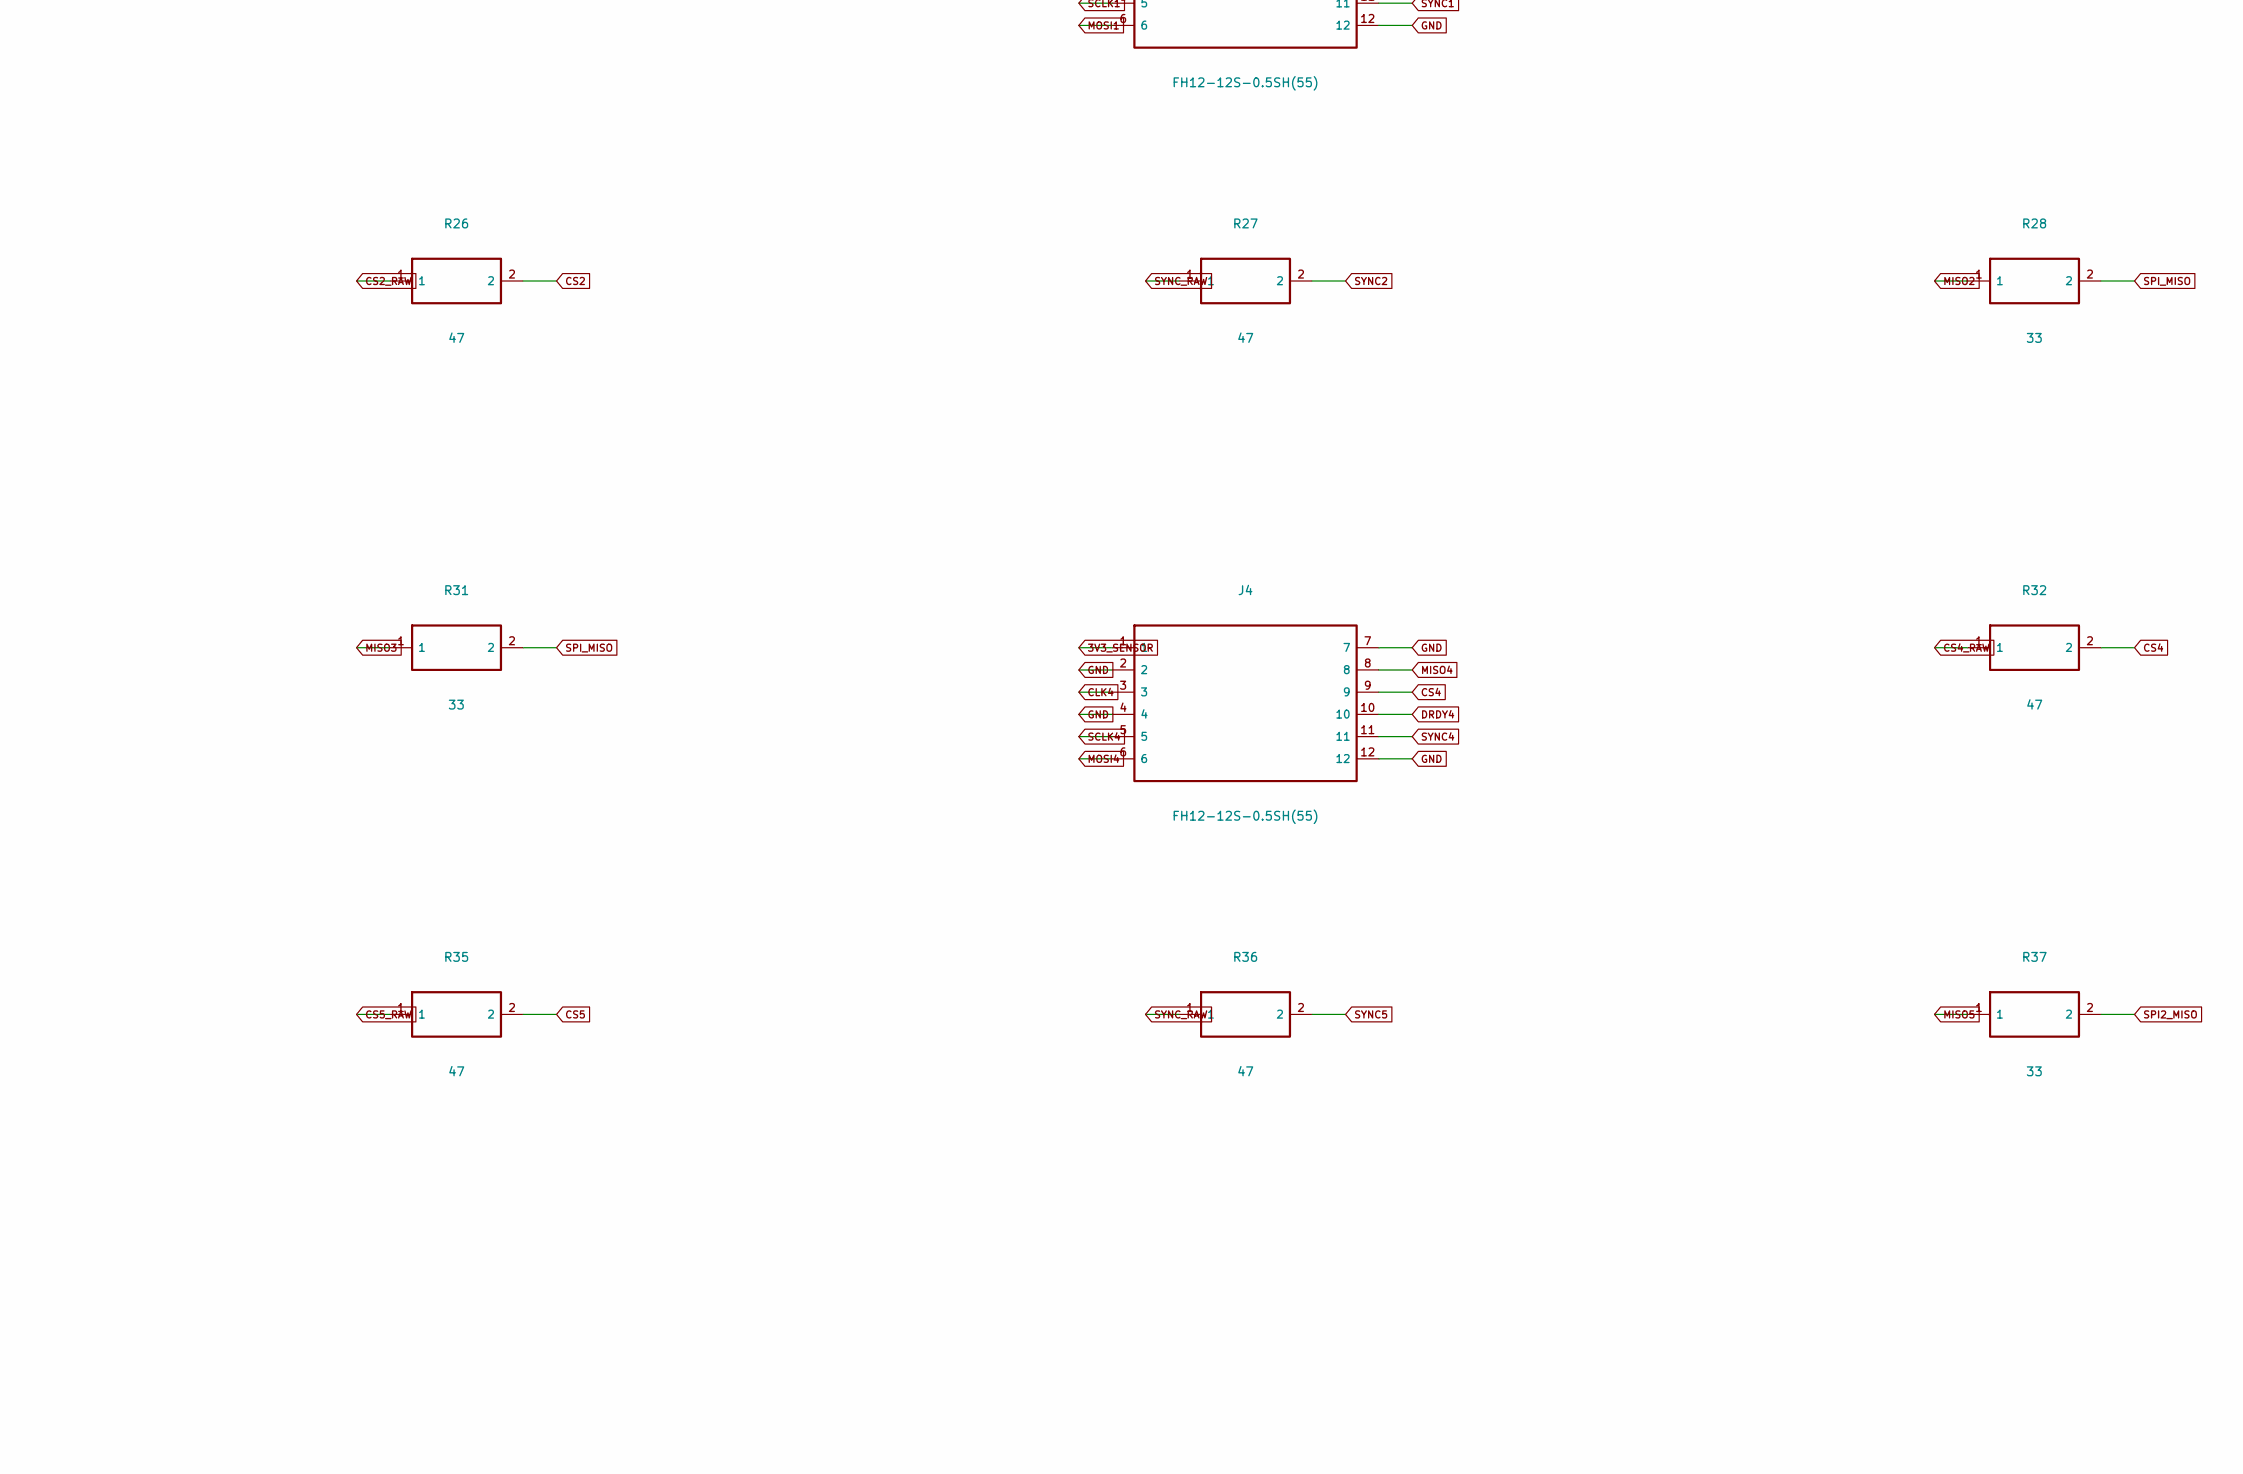
[picture p17: schematic finger-interfaces.kicad_sch, hand-hub - Finger Interfaces, part in row 2, column 2]

Parts:
C11, C12, C13: 100n; C_0402_1005Metric; MPN 100n
J1, J2, J3, J4, J5: FH12-12S-0.5SH(55); Hirose_FH12-12S-0.5SH_1x12-1MP_P0.50mm_Horizontal; MPN FH12-12S-0.5SH(55)
R7, R25, R28, R31, R34, R37: 33; R_0402_1005Metric; MPN 33
R8, R9, R10, R11, R12, R13, R14, R15, R16, R17, R18, R19, R20, R21, R22: 120; R_0402_1005Metric; MPN RC0402FR-07120RL
R23, R24, R26, R27, R29, R30, R32, R33, R35, R36: 47; R_0402_1005Metric; MPN 47
R38, R39: 100k; R_0402_1005Metric; MPN 100k
U4, U5: SN74LVC244APWR; TSSOP-20_4.4x6.5mm_P0.65mm; MPN SN74LVC244APWR
Y1: 3N08192G33YC; SJK_3N_3225; MPN 3N08192G33YC

Connections:
3V3_SENSOR: C11.1, C12.1, C13.1, J1.1, J2.1, J3.1, J4.1, J5.1, U4.20 (VCC), U5.20 (VCC), Y1.1 (EN), Y1.4 (VDD); also elsewhere on the board
ADC_CLK_TIMER: U4.2 (1A0), U4.4 (1A1), U4.6 (1A2), U4.8 (1A3), U4.17 (2A0); also elsewhere on the board
CLK1: J1.3, R8.2
CLK1_RAW: R8.1, U4.18 (1Y0)
CLK2: J2.3, R9.2
CLK2_RAW: R9.1, U4.16 (1Y1)
CLK3: J3.3, R10.2
CLK3_RAW: R10.1, U4.14 (1Y2)
CLK4: J4.3, R11.2
CLK4_RAW: R11.1, U4.12 (1Y3)
CLK5: J5.3, R12.2
CLK5_RAW: R12.1, U4.3 (2Y0)
CLK_MAIN: R7.1, Y1.3 (OUT)
CS1: J1.9, R23.2
CS1_RAW: R23.1; also elsewhere on the board
CS2: J2.9, R26.2
CS2_RAW: R26.1; also elsewhere on the board
CS3: J3.9, R29.2
CS3_RAW: R29.1; also elsewhere on the board
CS4: J4.9, R32.2
CS4_RAW: R32.1; also elsewhere on the board
CS5: J5.9, R35.2
CS5_RAW: R35.1; also elsewhere on the board
DRDY1: J1.10; also elsewhere on the board
DRDY2: J2.10; also elsewhere on the board
DRDY3: J3.10; also elsewhere on the board
DRDY4: J4.10; also elsewhere on the board
DRDY5: J5.10; also elsewhere on the board
GND: C11.2, C12.2, C13.2, J1.2, J1.4, J1.7, J1.12, J2.2, J2.4, J2.7, J2.12, J3.2, J3.4, J3.7, J3.12, J4.2, J4.4, J4.7, J4.12, J5.2, J5.4, J5.7, J5.12, R38.2, R39.2, U4.1 (1OE), U4.10 (GND), U4.19 (2OE), U5.1 (1OE), U5.10 (GND), U5.11 (2A3), U5.19 (2OE), Y1.2 (GND); also elsewhere on the board
HSE_IN: R7.2; also elsewhere on the board
MISO1: J1.8, R25.1
MISO2: J2.8, R28.1
MISO3: J3.8, R31.1
MISO4: J4.8, R34.1
MISO5: J5.8, R37.1
MOSI1: J1.6, R18.2
MOSI1_RAW: R18.1, U5.14 (1Y2)
MOSI2: J2.6, R19.2
MOSI2_RAW: R19.1, U5.12 (1Y3)
MOSI3: J3.6, R20.2
MOSI3_RAW: R20.1, U5.3 (2Y0)
MOSI4: J4.6, R21.2
MOSI4_RAW: R21.1, U5.5 (2Y1)
MOSI5: J5.6, R22.2
MOSI5_RAW: R22.1, U5.7 (2Y2)
SCLK1: J1.5, R13.2
SCLK1_RAW: R13.1, U4.5 (2Y1)
SCLK2: J2.5, R14.2
SCLK2_RAW: R14.1, U4.7 (2Y2)
SCLK3: J3.5, R15.2
SCLK3_RAW: R15.1, U4.9 (2Y3)
SCLK4: J4.5, R16.2
SCLK4_RAW: R16.1, U5.18 (1Y0)
SCLK5: J5.5, R17.2
SCLK5_RAW: R17.1, U5.16 (1Y1)
SPI2_MISO: R34.2, R37.2, R39.1; also elsewhere on the board
SPI2_MOSI: U5.13 (2A2), U5.15 (2A1); also elsewhere on the board
SPI2_SCLK: U5.2 (1A0), U5.4 (1A1); also elsewhere on the board
SPI_MISO: R25.2, R28.2, R31.2, R38.1; also elsewhere on the board
SPI_MOSI: U5.6 (1A2), U5.8 (1A3), U5.17 (2A0); also elsewhere on the board
SPI_SCLK: U4.11 (2A3), U4.13 (2A2), U4.15 (2A1); also elsewhere on the board
SYNC1: J1.11, R24.2
SYNC2: J2.11, R27.2
SYNC3: J3.11, R30.2
SYNC4: J4.11, R33.2
SYNC5: J5.11, R36.2
SYNC_RAW: R24.1, R27.1, R30.1, R33.1, R36.1; also elsewhere on the board

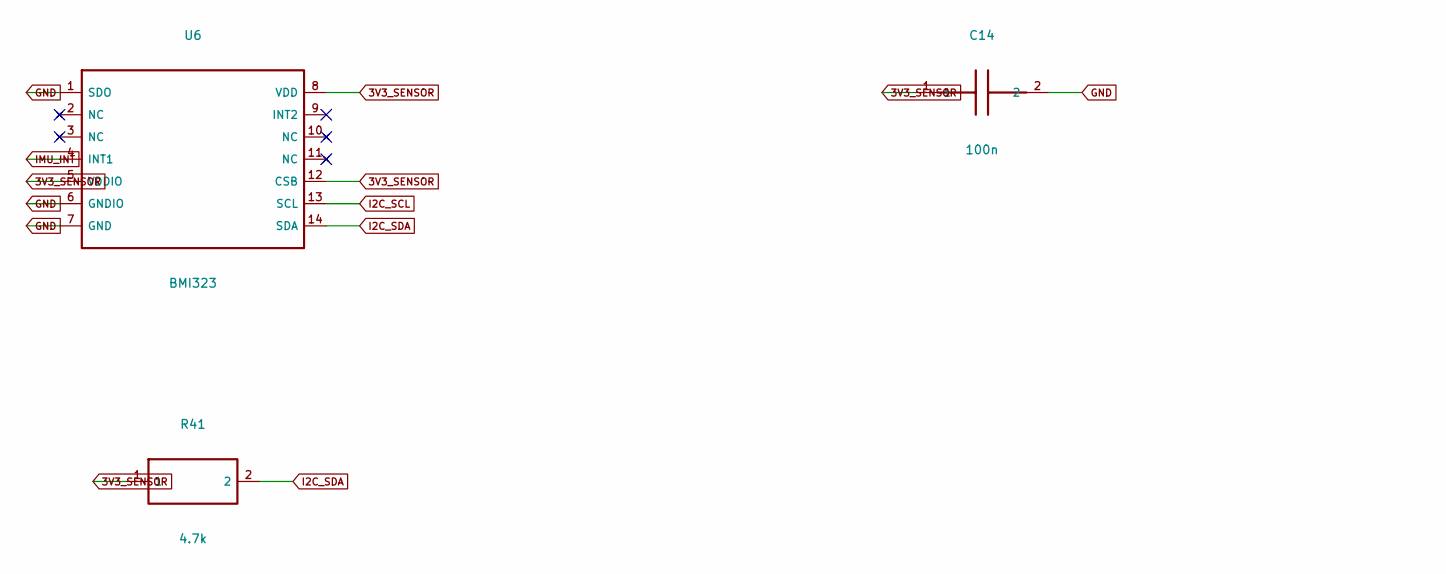
[picture p18: schematic hand-imu.kicad_sch, hand-hub - Hand IMU, part in row 1, column 1]

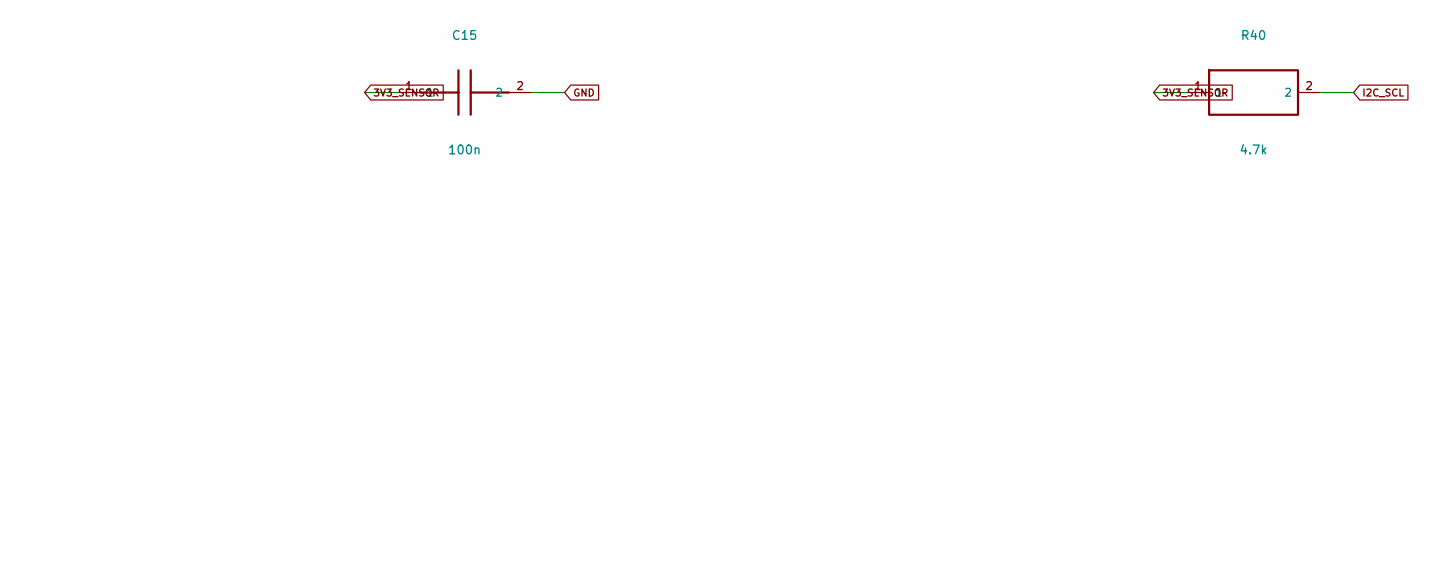
[picture p19: schematic hand-imu.kicad_sch, hand-hub - Hand IMU, part in row 1, column 2]

Parts:
C14, C15: 100n; C_0402_1005Metric; MPN 100n
R40, R41: 4.7k; R_0402_1005Metric; MPN 4.7k
U6: BMI323; Bosch_LGA-14_3x2.5mm_P0.5mm; MPN BMI323

Connections:
3V3_SENSOR: C14.1, C15.1, R40.1, R41.1, U6.5 (VDDIO), U6.8 (VDD), U6.12 (CSB); also elsewhere on the board
GND: C14.2, C15.2, U6.1 (SDO), U6.6 (GNDIO), U6.7 (GND); also elsewhere on the board
I2C_SCL: R40.2, U6.13 (SCL); also elsewhere on the board
I2C_SDA: R41.2, U6.14 (SDA); also elsewhere on the board
IMU_INT: U6.4 (INT1); also elsewhere on the board
