6thSense-dev/mocap-glove/hardware/pcb/v6/hand-hub/hand-hub.kicad_pcb

## KiCad design hardware/pcb/v6/hand-hub/hand-hub.kicad_pcb (continued)

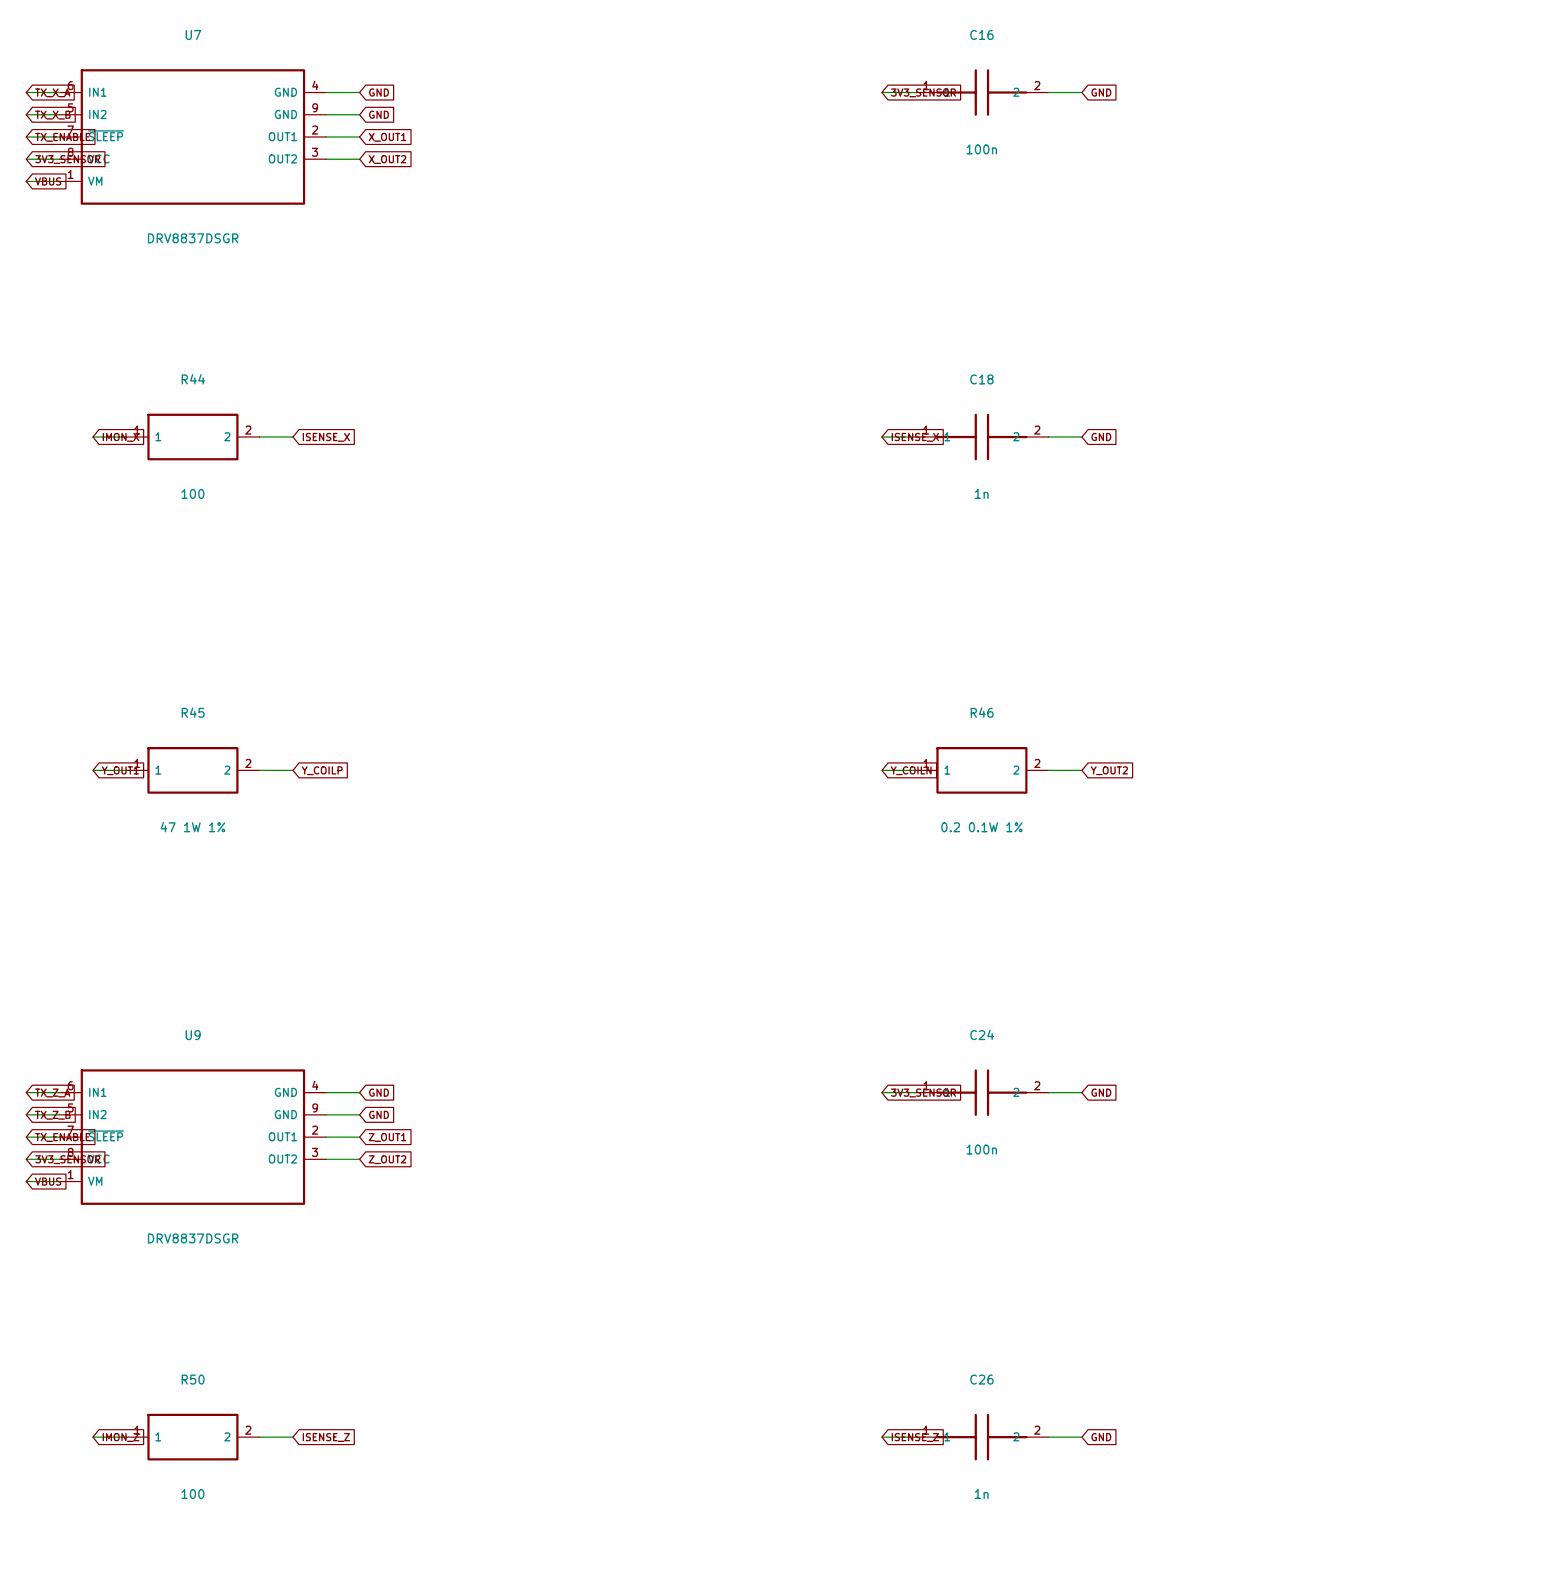
[picture p20: schematic magnetic-source-drivers.kicad_sch, hand-hub - Magnetic Source Drivers, part in row 1, column 1]

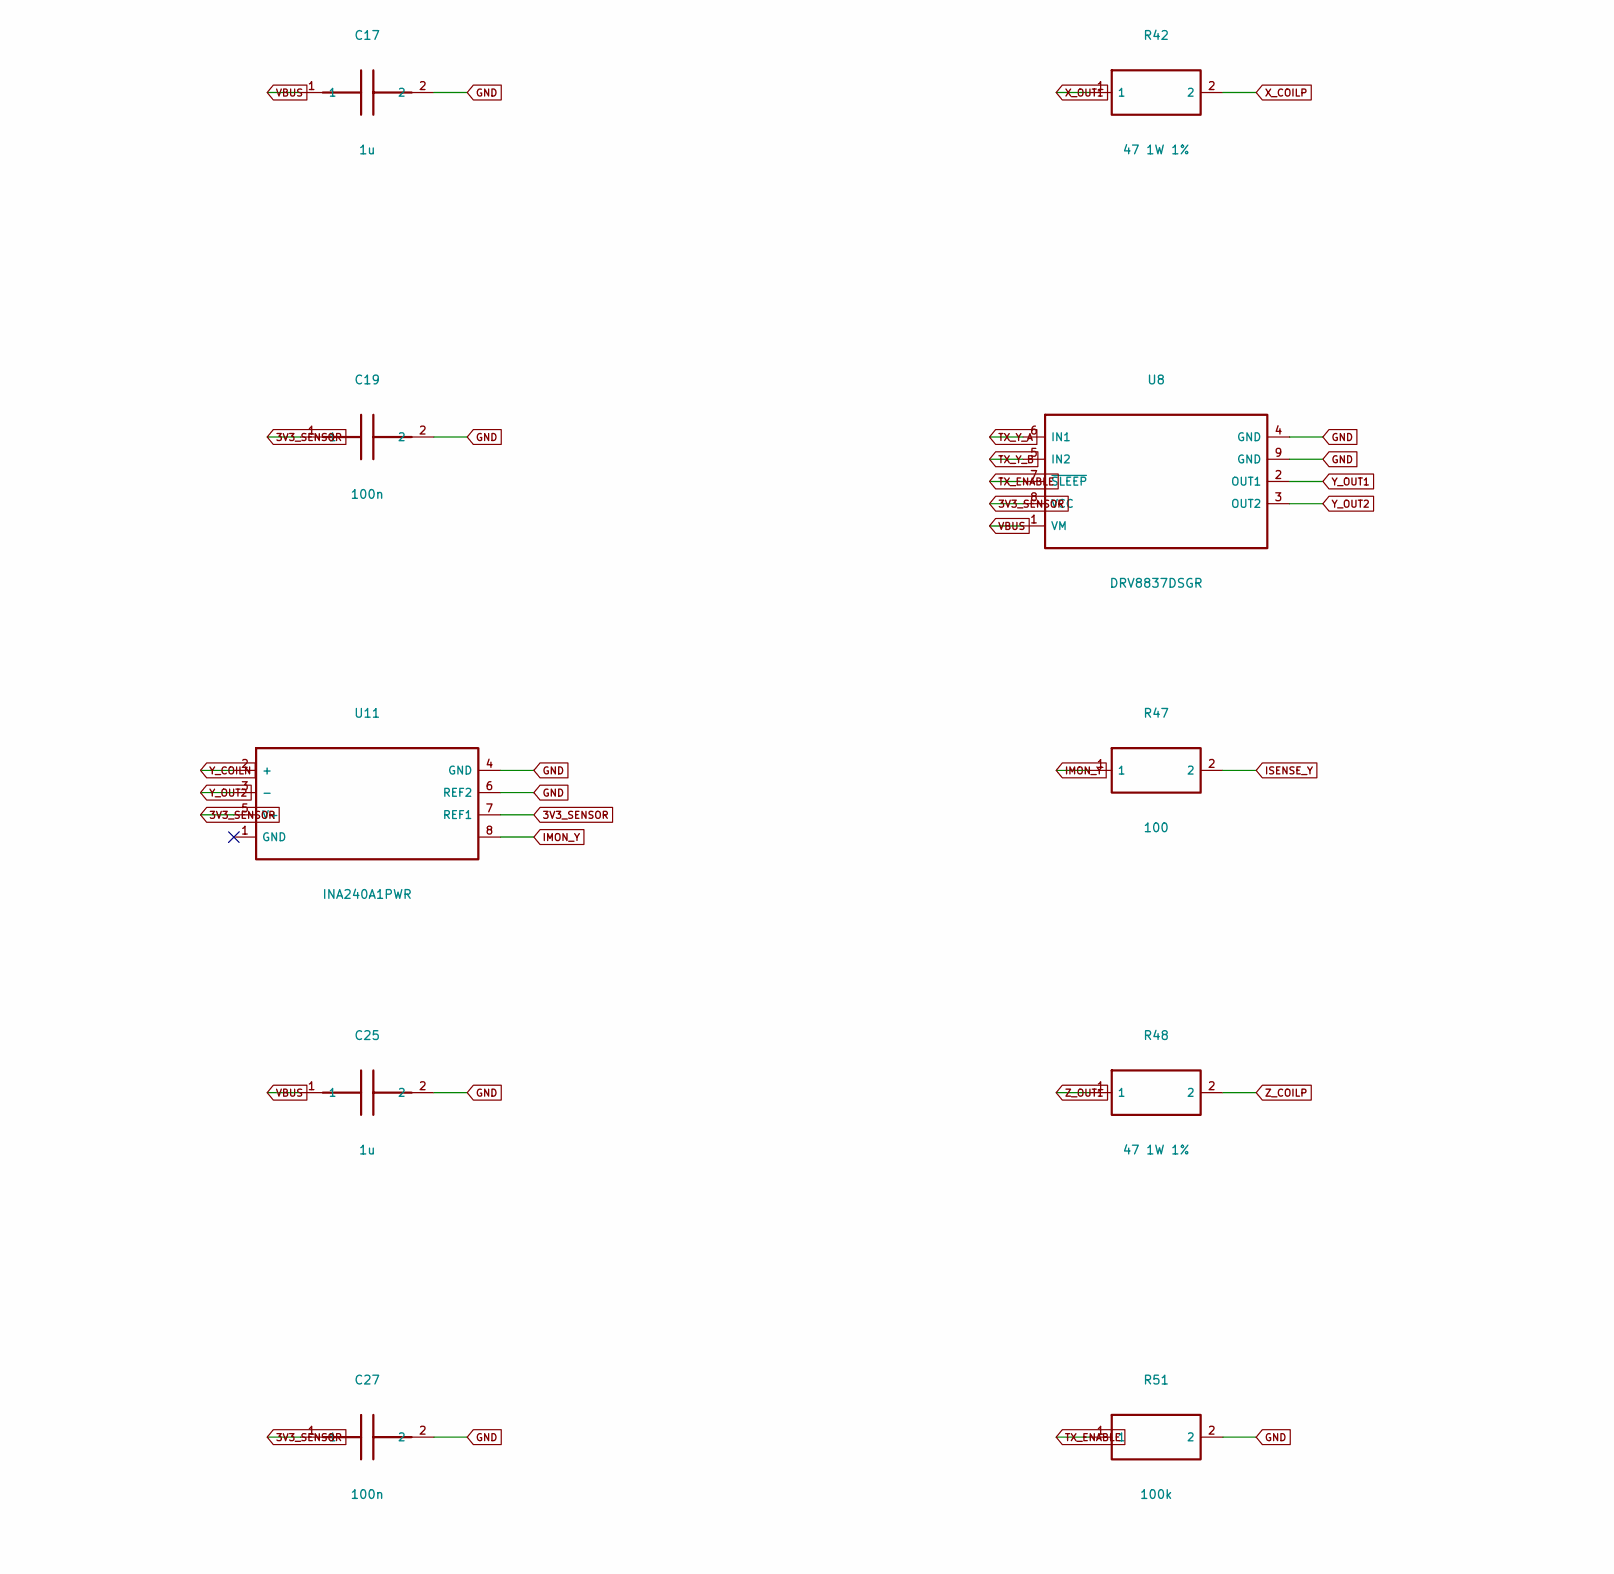
[picture p21: schematic magnetic-source-drivers.kicad_sch, hand-hub - Magnetic Source Drivers, part in row 1, column 2]

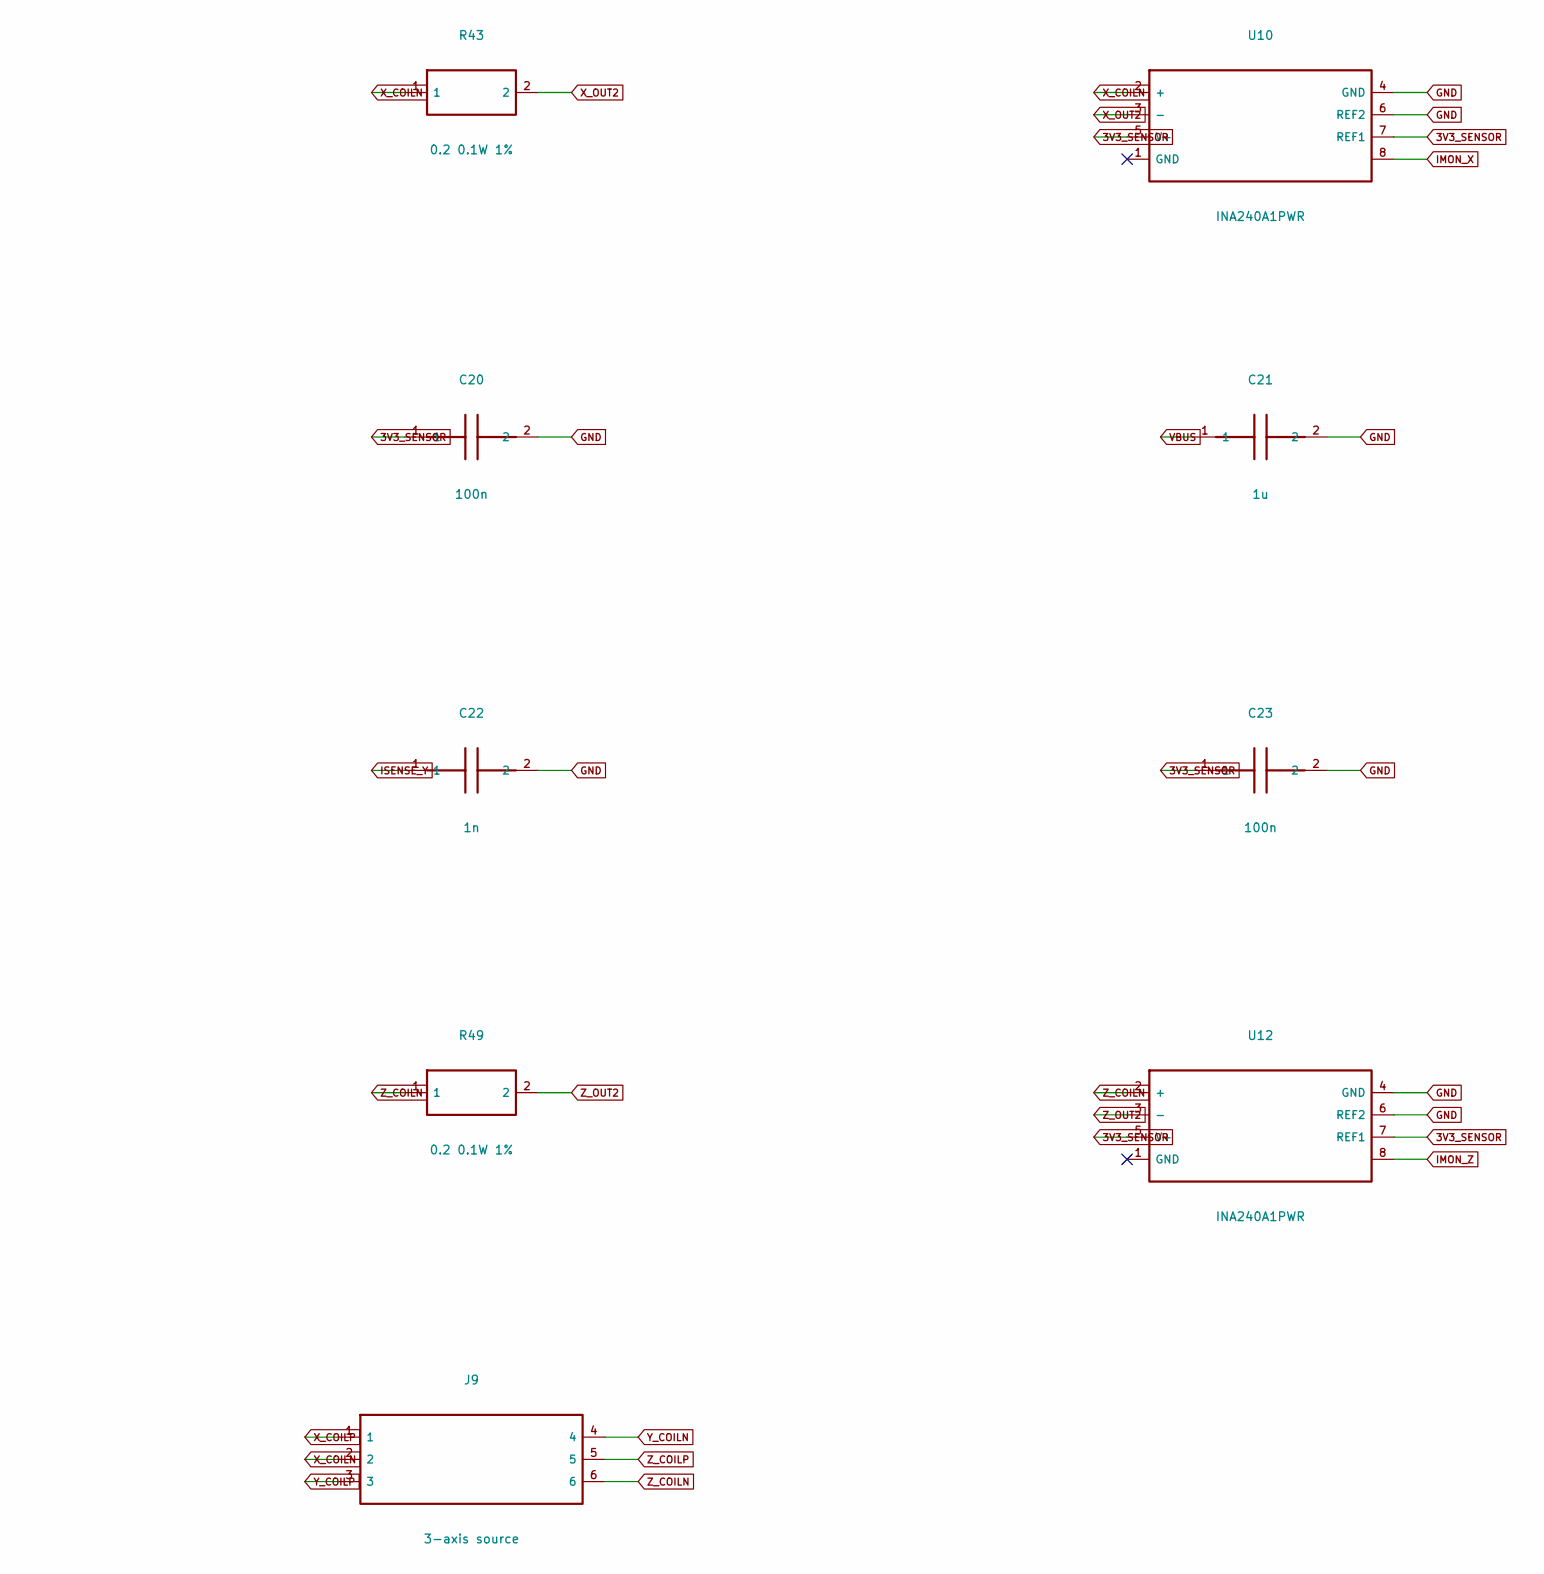
[picture p22: schematic magnetic-source-drivers.kicad_sch, hand-hub - Magnetic Source Drivers, part in row 1, column 3]

Parts:
C16, C19, C20, C23, C24, C27: 100n; C_0402_1005Metric; MPN 100n
C17, C21, C25: 1u; C_0402_1005Metric; MPN 1u
C18, C22, C26: 1n; C_0402_1005Metric; MPN 1n
J9: 3-axis source; JST_SH_BM06B-SRSS-TB_1x06-1MP_P1.00mm_Vertical; MPN BM06B-SRSS-TB(LF)(SN)
R42, R45, R48: 47 1W 1%; R_2512_6332Metric; MPN FRR2512F47R0TS
R43, R46, R49: 0.2 0.1W 1%; R_0603_1608Metric; MPN RL0603FR-070R2L
R44, R47, R50: 100; R_0402_1005Metric; MPN 100
R51: 100k; R_0402_1005Metric; MPN 100k
U7, U8, U9: DRV8837DSGR; WSON-8-1EP_2x2mm_P0.5mm_EP0.9x1.6mm; MPN DRV8837DSGR
U10, U11, U12: INA240A1PWR; TSSOP-8_4.4x3mm_P0.65mm; MPN INA240A1PWR

Connections:
3V3_SENSOR: C16.1, C19.1, C20.1, C23.1, C24.1, C27.1, U7.8 (VCC), U8.8 (VCC), U9.8 (VCC), U10.5 (V+), U10.7 (REF1), U11.5 (V+), U11.7 (REF1), U12.5 (V+), U12.7 (REF1); also elsewhere on the board
GND: C16.2, C17.2, C18.2, C19.2, C20.2, C21.2, C22.2, C23.2, C24.2, C25.2, C26.2, C27.2, R51.2, U7.4 (GND), U7.9 (GND), U8.4 (GND), U8.9 (GND), U9.4 (GND), U9.9 (GND), U10.4 (GND), U10.6 (REF2), U11.4 (GND), U11.6 (REF2), U12.4 (GND), U12.6 (REF2); also elsewhere on the board
IMON_X: R44.1, U10.8
IMON_Y: R47.1, U11.8
IMON_Z: R50.1, U12.8
ISENSE_X: C18.1, R44.2; also elsewhere on the board
ISENSE_Y: C22.1, R47.2; also elsewhere on the board
ISENSE_Z: C26.1, R50.2; also elsewhere on the board
TX_ENABLE: R51.1, U7.7 (~SLEEP), U8.7 (~SLEEP), U9.7 (~SLEEP); also elsewhere on the board
TX_X_A: U7.6 (IN1); also elsewhere on the board
TX_X_B: U7.5 (IN2); also elsewhere on the board
TX_Y_A: U8.6 (IN1); also elsewhere on the board
TX_Y_B: U8.5 (IN2); also elsewhere on the board
TX_Z_A: U9.6 (IN1); also elsewhere on the board
TX_Z_B: U9.5 (IN2); also elsewhere on the board
VBUS: C17.1, C21.1, C25.1, U7.1 (VM), U8.1 (VM), U9.1 (VM); also elsewhere on the board
X_COILN: J9.2, R43.1, U10.2 (+)
X_COILP: J9.1, R42.2
X_OUT1: R42.1, U7.2 (OUT1)
X_OUT2: R43.2, U7.3 (OUT2), U10.3 (-)
Y_COILN: J9.4, R46.1, U11.2 (+)
Y_COILP: J9.3, R45.2
Y_OUT1: R45.1, U8.2 (OUT1)
Y_OUT2: R46.2, U8.3 (OUT2), U11.3 (-)
Z_COILN: J9.6, R49.1, U12.2 (+)
Z_COILP: J9.5, R48.2
Z_OUT1: R48.1, U9.2 (OUT1)
Z_OUT2: R49.2, U9.3 (OUT2), U12.3 (-)

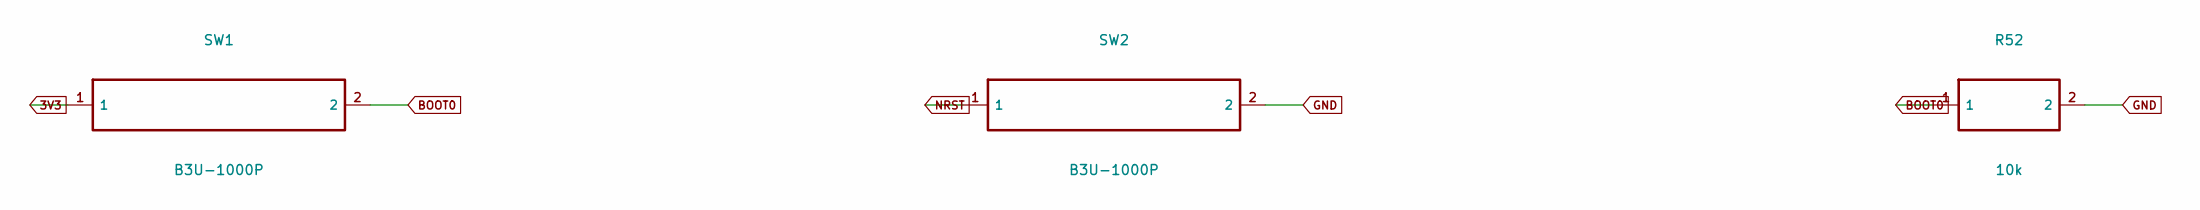
[picture p23: schematic usb-recovery.kicad_sch, hand-hub - USB recovery]

Parts:
R52: 10k; R_0402_1005Metric; MPN 10k
SW1, SW2: B3U-1000P; SW_SPST_B3U-1000P; MPN B3U-1000P

Connections:
3V3: SW1.1; also elsewhere on the board
BOOT0: R52.1, SW1.2; also elsewhere on the board
GND: R52.2, SW2.2; also elsewhere on the board
NRST: SW2.1; also elsewhere on the board

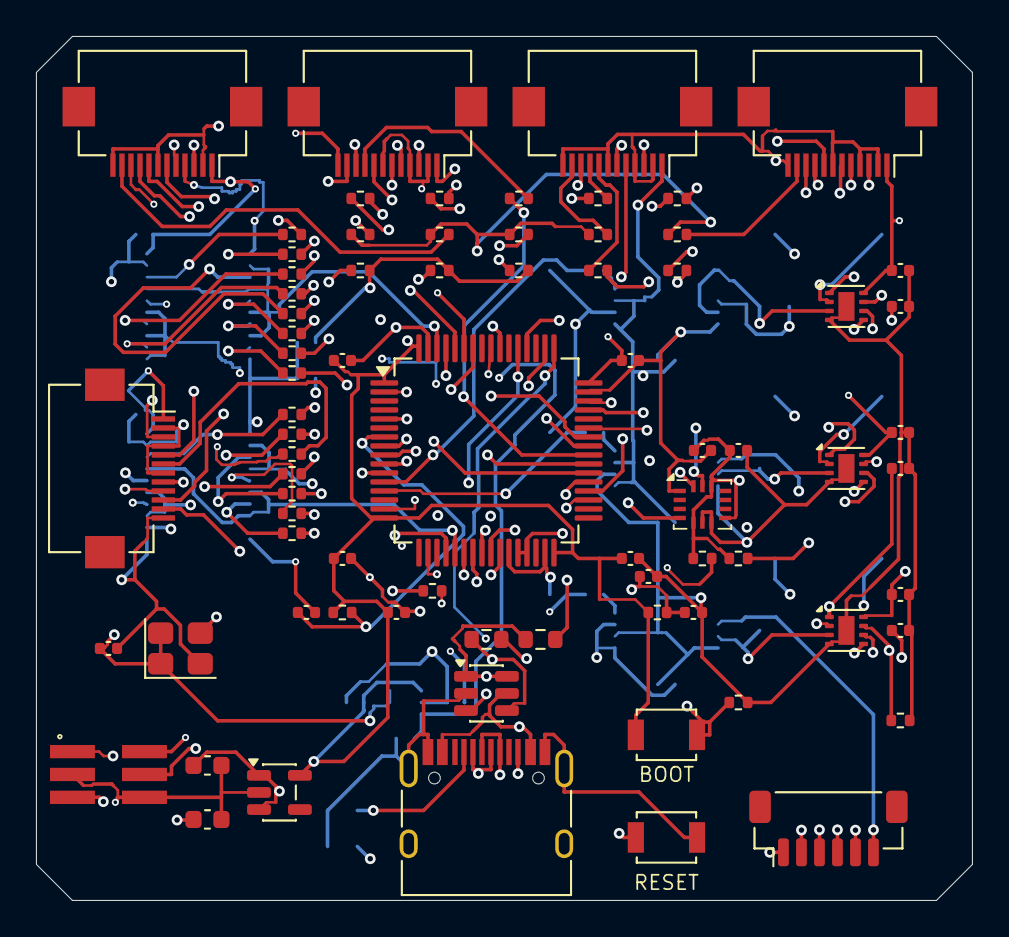
[picture p24: board hand-hub.kicad_pcb from above]

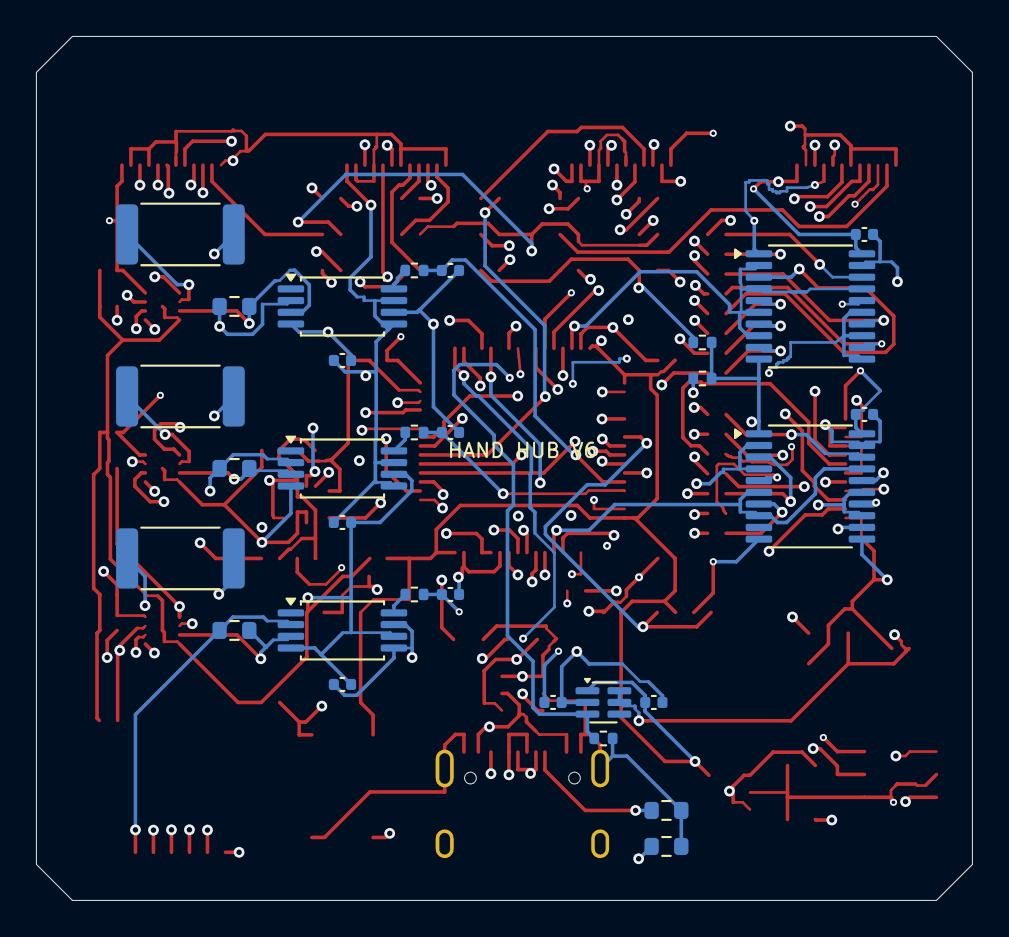
[picture p25: board hand-hub.kicad_pcb from below]

Board: 4 copper layers, 52.0 x 48.0 mm, 106 parts (30 on the bottom side), 109 nets.
