6thSense-dev/mocap-glove/hardware/pcb/v6/source-carrier/source-carrier.kicad_pcb

## KiCad design hardware/pcb/v6/source-carrier/source-carrier.kicad_pcb (2026-11-04)

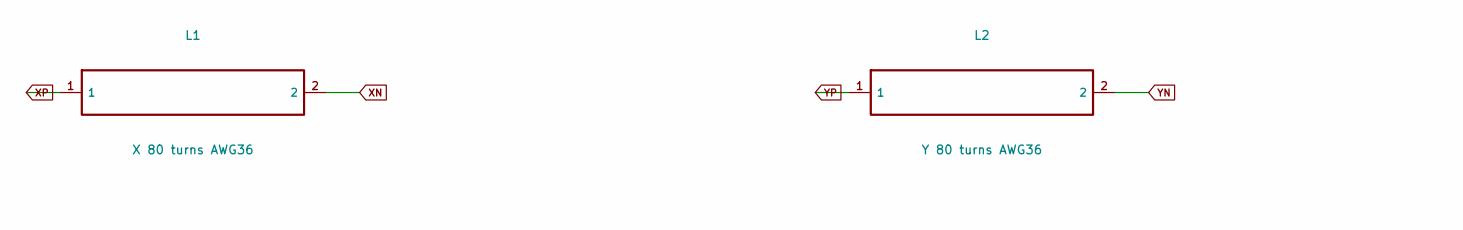
[picture p26: schematic three-axis-windings.kicad_sch, source-carrier - Three-axis windings, part in row 1, column 1]

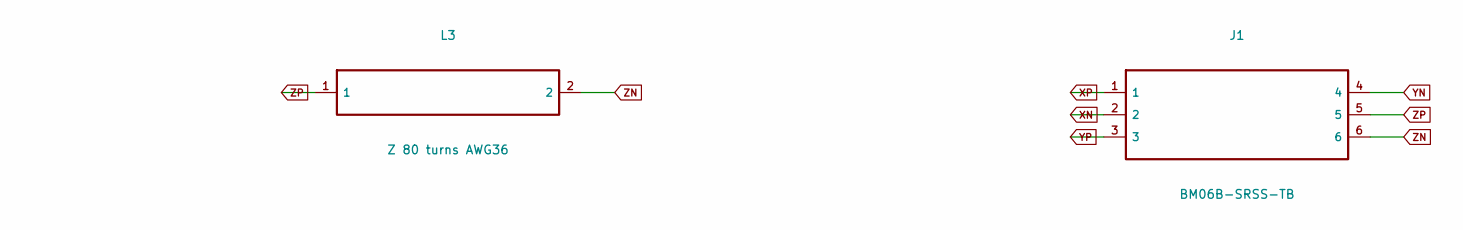
[picture p27: schematic three-axis-windings.kicad_sch, source-carrier - Three-axis windings, part in row 1, column 2]

Parts:
J1: BM06B-SRSS-TB; JST_SH_BM06B-SRSS-TB_1x06-1MP_P1.00mm_Vertical; MPN BM06B-SRSS-TB(LF)(SN)
L1: X 80 turns AWG36; WirePair_SourceAssembly; MPN CUSTOM_WOUND_X
L2: Y 80 turns AWG36; WirePair; MPN CUSTOM_WOUND_Y
L3: Z 80 turns AWG36; WirePair; MPN CUSTOM_WOUND_Z

Connections:
XN: J1.2, L1.2
XP: J1.1, L1.1
YN: J1.4, L2.2
YP: J1.3, L2.1
ZN: J1.6, L3.2
ZP: J1.5, L3.1

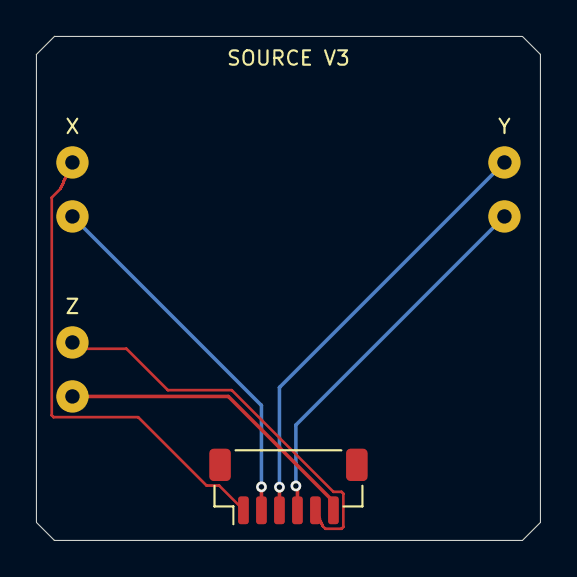
[picture p28: board source-carrier.kicad_pcb from above]

Board: 2 copper layers, 28.0 x 28.0 mm, 4 parts (0 on the bottom side), 6 nets.
