6thSense-dev/mocap-glove/firmware-app/include/source_waveform.h

// V6 host-generated table; validate DMA/timer setup on hardware before enabling drivers.
#include <stdint.h>
static const uint32_t source_bsrr[4096] = {
0x002A0015u, 0x002A0015u, 0x002A0015u, 0x002A0015u, 0x002A0015u, 0x002A0015u, 0x002A0015u, 0x002A0015u,
0x002A0015u, 0x002A0015u, 0x002A0015u, 0x002A0015u, 0x002A0015u, 0x002A0015u, 0x002A0015u, 0x002A0015u,
0x002A0015u, 0x002A0015u, 0x002A0015u, 0x002A0015u, 0x002A0015u, 0x002A0015u, 0x002A0015u, 0x002A0015u,
0x002A0015u, 0x002A0015u, 0x002A0015u, 0x002A0015u, 0x002A0015u, 0x002A0015u, 0x002A0015u, 0x002A0015u,
0x002A0015u, 0x002A0015u, 0x002A0015u, 0x002A0015u, 0x002A0015u, 0x002A0015u, 0x002A0015u, 0x002A0015u,
0x002A0015u, 0x002A0015u, 0x002A0015u, 0x002A0015u, 0x002A0015u, 0x002A0015u, 0x002A0015u, 0x002A0015u,
0x002A0015u, 0x002A0015u, 0x002A0015u, 0x002A0015u, 0x002A0015u, 0x002A0015u, 0x002A0015u, 0x002A0015u,
0x002A0015u, 0x001A0025u, 0x001A0025u, 0x001A0025u, 0x001A0025u, 0x001A0025u, 0x001A0025u, 0x001A0025u,
0x001A0025u, 0x001A0025u, 0x001A0025u, 0x001A0025u, 0x001A0025u, 0x00160029u, 0x00160029u, 0x00160029u,
0x00160029u, 0x00160029u, 0x00160029u, 0x00160029u, 0x00160029u, 0x00160029u, 0x00160029u, 0x00160029u,
0x00160029u, 0x00160029u, 0x00160029u, 0x00160029u, 0x00160029u, 0x00160029u, 0x0015002Au, 0x0015002Au,
0x0015002Au, 0x0015002Au, 0x0015002Au, 0x0015002Au, 0x0015002Au, 0x0015002Au, 0x0015002Au, 0x0015002Au,
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
0x00190026u, 0x00190026u, 0x00190026u, 0x00190026u, 0x00190026u, 0x00190026u, 0x00190026u, 0x00190026u,
0x00190026u, 0x00190026u, 0x00190026u, 0x00190026u, 0x00190026u, 0x00190026u, 0x00190026u, 0x00190026u,
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
};
