6thSense-dev/mocap-glove/control-panel/axis.js

const $=id=>document.getElementById(id);
let running=false,generation=0,busy=false,latest=null,noise=0,points=[],a=45.554,b=113.895,sessionStart=0,lastSampleTime=0,intervals=[],da=null,db=null,sensor=3,imuEnabled=false;
async function api(action,extra={}){const res=await fetch('/api/action',{method:'POST',headers:{'Content-Type':'application/json','X-Control-Token':CONTROL_TOKEN},body:JSON.stringify({action,...extra})});const data=await res.json();if(!res.ok)throw Error(data.error||'Hub request failed');return data;}
function note(t){$('message').textContent=t;}
let storageKey='6thsense-axis-distance-v1-J3-Z-Y';
function calibrated(){return $("displayMode").value==='cm'&&Number.isFinite(da)&&Number.isFinite(db)&&da!==db;}
const scale=()=>$("scaleMode").value;
function saveCalibration(){try{localStorage.setItem(storageKey,JSON.stringify({a,b,da,db,direction:$('direction').value}));}catch(e){note('Calibration works for this session, but browser storage is unavailable.');}}
function refs(){ $('aValue').textContent=a.toFixed(2)+' counts';$('bValue').textContent=b.toFixed(2)+' counts';
for(const name of ['A','B']){const d=name==='A'?da:db;$('saved'+name).textContent=Number.isFinite(d)?'Saved at '+(d>0?'+':'')+d+' cm':'Signal endpoint · no distance needed';}
$('aLabel').textContent=calibrated()?'A · '+da+' cm':'A · 0%';$('bLabel').textContent=calibrated()?'B · '+db+' cm':'B · 100%';
$('calibration').textContent=calibrated()?'Two measured endpoints saved on this Mac. Positive direction: '+$('direction').value+'. Recalibrate after changing the setup.':($('displayMode').value==='percent'?'Set your 0% and 100% endpoints from live readings. No physical distances are required.':'Save a signed distance at both endpoints to enable centimetres.');}
try{const c=JSON.parse(localStorage.getItem(storageKey));if(c&&[c.a,c.b].every(Number.isFinite)&&Math.abs(c.b-c.a)>=3&&[c.da,c.db].every(x=>x===null||Number.isFinite(x))){a=c.a;b=c.b;da=c.da;db=c.db;for(const n of ['A','B']){const d=n==='A'?da:db;$('distance'+n).value=d===null?'':d;}if([...$('direction').options].some(x=>x.value===c.direction))$('direction').value=c.direction;}}catch(e){}

function display(){const fresh=latest&&Date.now()-latest.time<1000;const good=fresh&&AxisModel.quality(latest.value,noise,latest.clipped);const p=good?AxisModel.position(latest.value,a,b,scale()):null;
$('signal').textContent=latest?latest.value.toFixed(2)+' counts':'— counts';$('age').textContent=latest?(Math.floor((Date.now()-latest.time)/1000)+' s since last sample'+(!running?' · paused':'')):'No live sample';
const d=good&&calibrated()?AxisModel.distance(latest.value,a,b,da,db,scale()):null;
$('positionLabel').textContent=calibrated()?'ESTIMATED POSITION · '+$('direction').value.toUpperCase()+' IS +':(scale()==='dipole'?'THEORETICAL DISTANCE · RELATIVE %':'RAW SIGNAL · RELATIVE %');$('positionUnit').textContent=calibrated()?' cm':' %';
$('position').textContent=calibrated()?(d===null?'—':(d>0?'+':'')+d.toFixed(1)):(p===null?'—':p.toFixed(1));$('dot').className='dot'+(p===null?' invalid':'');$('dot').setAttribute('aria-label',p===null?'No valid live position':(calibrated()?(d===null?'Outside distance calibration':d.toFixed(1)+' centimetres estimated position'):p.toFixed(1)+' percent signal-based position'));if(p!==null){const lo=Math.min(0,Math.floor(p/25)*25),hi=Math.max(100,Math.ceil(p/25)*25);$('dot').style.left=(100*(p-lo)/(hi-lo))+'%';if(!calibrated()){$('aLabel').textContent=lo+'%';$('bLabel').textContent=hi+'%';}}
$('saveA').disabled=$('saveB').disabled=!good||!running||busy;$('start').disabled=running||busy;$('pause').disabled=!running&&!busy;
if(running&&latest&&!fresh)note('Reading stale. Position hidden until a new valid sample arrives.');
return p;}
async function pause(message='Paused. Coil outputs off requested.'){running=false;generation++;imuEnabled=false;ImuView.error('Paused · last tilt held');$('status').textContent='Paused';note(message);display();try{await fetch('/api/stop',{method:'POST',headers:{'X-Control-Token':CONTROL_TOKEN}});}catch(e){note('Stop could not reach the hub. Unplug USB if needed.');}}
function consume(s){const c=s.capture;const spec=c?.spectrum?.[String(sensor)];if(!c?.transmitter||c.axes!==4||c.mask!==(1<<(sensor-1))||!spec)throw Error('Unexpected capture source; stopped.');const stamp=performance.now();if(lastSampleTime){intervals.push(stamp-lastSampleTime);intervals=intervals.slice(-20);$('rate').textContent=(1000/(intervals.reduce((a,b)=>a+b,0)/intervals.length)).toFixed(1)+' Hz measured';}lastSampleTime=stamp;const tone=spec.amplitudes.find(x=>x.hz===6750);latest={value:tone.xyz_counts[1],clipped:spec.clipped,time:Date.now()};const p=display();if(p===null)note(spec.clipped?'Signal saturated. Move the receiver farther away.':(!AxisModel.quality(latest.value,noise,latest.clipped)?'Signal too weak. Check alignment.':'Set 0% and 100% from live readings. The theoretical model needs two distinct, positive signal endpoints; a zero-count placeholder cannot be used.'));else {note(p<0||p>100?(calibrated()?'Outside the calibrated range. Distance hidden; move between your taught positions.':'Beyond your saved endpoints. Percentage is extrapolated; the rail expands to show it.'):(calibrated()?'Live estimated distance · two-point interpolation. Keep orientation fixed.':(scale()==='dipole'?'Live inverse-cube distance approximation · keep alignment fixed.':'Live linear signal percentage · no distance required.')));points.push(p);points=points.slice(-30);const low=Math.min(0,...points),high=Math.max(100,...points);$('trail').setAttribute('d',points.map((v,i)=>(i?'L':'M')+(15+i*870/29)+','+(90-80*(v-low)/(high-low))).join(' '));}}
async function tick(g){if(!running||g!==generation)return;if(document.hidden||Date.now()-sessionStart>120000){await pause('Session paused. Press Start to continue.');return;}const started=performance.now();busy=true;display();try{const s=await api('capture_live',{mask:1<<(sensor-1),axes:4,bench_ready:true});if(g===generation){consume(s);if(imuEnabled){try{const imu=await api('imu_read');if(g===generation)ImuView.update(imu.diagnostics.imu_read.reply);}catch(e){ImuView.error(e.message);}}}}catch(e){if(g===generation)await pause(e.message);}finally{busy=false;display();}if(running&&g===generation)setTimeout(()=>tick(g),Math.max(100-(performance.now()-started),85));}
$('start').onclick=async()=>{if(running||busy)return;running=true;busy=true;const g=++generation;sessionStart=Date.now();latest=null;lastSampleTime=0;intervals=[];points=[];$('trail').setAttribute('d','');$('status').textContent='Starting';note('Checking hub and measuring coil-off background…');display();try{let s=await api('connect');if(g!==generation)return;if(!['0.2.3-diagnostics','0.2.4-diagnostics'].includes(s.status.firmware))throw Error('Fast mode needs firmware 0.2.3. Put the hub in BOOT mode for the update.');if(!s.status.sensors){await api('power_on');if(g!==generation)return;}s=await api('probe');if(g!==generation)return;const found=s.status.found;if(!found)throw Error('No receiver detected. Check the flex connection with USB unplugged.');if(found&(found-1))throw Error('This one-axis view currently needs exactly one connected receiver.');const detected=Math.log2(found)+1;if(detected!==sensor){sensor=detected;storageKey='6thsense-axis-distance-v1-J'+sensor+'-Z-Y';a=5;b=100;da=db=null;try{const c=JSON.parse(localStorage.getItem(storageKey));if(c&&[c.a,c.b].every(Number.isFinite)&&Math.abs(c.b-c.a)>=3&&[c.da,c.db].every(x=>x===null||Number.isFinite(x))){a=c.a;b=c.b;da=c.da;db=c.db;if([...$('direction').options].some(x=>x.value===c.direction))$('direction').value=c.direction;}}catch(e){}refs();}$('port').textContent='J'+sensor+' · Z transmitter';s=await api('capture',{mask:found});if(g!==generation)return;const spec=s.capture.spectrum[String(sensor)];if(spec.clipped)throw Error('Background signal is saturated; check the receiver before starting.');noise=spec.amplitudes.find(x=>x.hz===6750).xyz_counts[1];imuEnabled=false;try{await api('imu_on');if(g!==generation)return;imuEnabled=true;}catch(e){ImuView.error('IMU unavailable: '+e.message);}$('status').textContent='Live · Z-only bursts';}catch(e){await pause(e.message);}finally{busy=false;display();}if(running&&g===generation)setTimeout(()=>tick(g),2200);};
$('pause').onclick=()=>pause();
for(const name of ['A','B'])$('save'+name).onclick=()=>{if(!latest||Date.now()-latest.time>=1000||!AxisModel.quality(latest.value,noise,latest.clipped))return;const useDistance=$('displayMode').value==='cm',text=$('distance'+name).value.trim(),d=useDistance?Number(text):null;if(useDistance&&(!text||!Number.isFinite(d))){note('Enter a signed distance, or switch Display to Percentage to calibrate without distances.');return;}const other=name==='A'?b:a,otherDistance=name==='A'?db:da;if(useDistance&&d===otherDistance){note('A and B need different physical distances.');return;}if(Math.abs(latest.value-other)<Math.max(3,noise*6)){note('Those signals are too similar. Move to a more distinct endpoint.');return;}if(name==='A'){a=latest.value;da=d;}else{b=latest.value;db=d;}refs();saveCalibration();points=[];$('trail').setAttribute('d','');display();};
$('resetRefs').onclick=()=>{a=sensor===3?45.554:5;b=sensor===3?113.895:100;da=db=null;$('distanceA').value=$('distanceB').value='';refs();saveCalibration();points=[];$('trail').setAttribute('d','');display();};
function modeChanged(){for(const e of document.querySelectorAll('.distanceEntry'))e.hidden=$('displayMode').value!=='cm';$('saveA').textContent=$('displayMode').value==='cm'?'Save A at this distance':'Set 0% here';$('saveB').textContent=$('displayMode').value==='cm'?'Save B at this distance':'Set 100% here';$('modelHelp').textContent=scale()==='dipole'?'Field ∝ 1/r³ → relative distance ∝ signal⁻¹ᐟ³. Approximate far-field model; keep orientation and field geometry fixed.':'Linear signal scale: equal changes in amplitude give equal changes in percentage.';points=[];$('trail').setAttribute('d','');refs();display();}
$('displayMode').onchange=$('scaleMode').onchange=modeChanged;
$('direction').onchange=()=>{da=db=null;refs();saveCalibration();display();note('Direction changed. Save both measured positions again using the new sign convention.');};
document.addEventListener('visibilitychange',()=>{if(document.hidden&&(running||busy))pause('Paused because this tab was hidden.');});
window.addEventListener('pagehide',()=>{running=false;generation++;fetch('/api/stop',{method:'POST',headers:{'X-Control-Token':CONTROL_TOKEN},keepalive:true}).catch(()=>{});});
setInterval(display,500);setInterval(()=>{if(running&&!busy)fetch('/api/state',{headers:{'X-Control-Token':CONTROL_TOKEN}}).catch(()=>{});},5000);refs();display();
