6thSense-dev/mocap-glove/control-panel/hand.js

'use strict';
const $=id=>document.getElementById(id), orientation=new HandOrientation(), translation=new HandTranslation(), identity=[[1,0,0],[0,1,0],[0,0,1]];
let hubPosition=[0,0,0], hubRotation=identity, state={}, running=false, stopping=false, imuAt=0, poses={}, poseAt=0, lastCapture=0, session=0, imuCount=0, detectedMask=0, interval=2300, captures=0, groupIndex=0, captureFault='', rangeBaselines={}, panelAt=0;
const zReflection=new HandZReflection({getItem:k=>localStorage.getItem(k),setItem:(k,v)=>localStorage.setItem(k,v)});
function showZ(){const reversed=[1,2,3,4,5].filter(p=>zReflection.enabled(p));$('z-status').textContent='Reverse Z: '+(reversed.length?reversed.map(p=>'J'+p).join(', '):'off')+' · local X/Y unchanged · display correction, not physical calibration';}
$('reverse-z').onclick=()=>{if(!detectedMask){text('Start tracking to detect the connected fingers first.');return;}zReflection.setConnected(detectedMask,true);showZ();renderPorts();};$('normal-z').onclick=()=>{zReflection.setConnected(detectedMask||31,false);showZ();renderPorts();};showZ();
const displaySettings=new HandDisplaySettings({getItem:k=>localStorage.getItem(k),setItem:(k,v)=>localStorage.setItem(k,v)});
const sourceFrame=new HandSourceFrame({getItem:k=>localStorage.getItem(k),setItem:(k,v)=>localStorage.setItem(k,v)});
const settingsOpen=new Set(),movementMode=new HandMovementMode({getItem:k=>localStorage.getItem(k),setItem:(k,v)=>localStorage.setItem(k,v)});
let viewFrame=localStorage.getItem('6thsense.view-frame.v1')||'room';$('view-frame').value=viewFrame;$('view-frame').onchange=()=>{viewFrame=$('view-frame').value;localStorage.setItem('6thsense.view-frame.v1',viewFrame);};
let lastImuId=null,orientationHistory={},imuMount=identity;$('robot-overlay').checked=localStorage.getItem('6thsense.robot-overlay.v1')!=='false';$('robot-overlay').onchange=()=>localStorage.setItem('6thsense.robot-overlay.v1',String($('robot-overlay').checked));
const fingerAlignment=new HandFingerAlignment({getItem:k=>localStorage.getItem(k),setItem:(k,v)=>localStorage.setItem(k,v)}),alignmentOpen=new Set();
const viewZoom=new HandViewZoom({getItem:k=>localStorage.getItem(k),setItem:(k,v)=>localStorage.setItem(k,v)});
const camera=new HandCameraView({getItem:k=>localStorage.getItem(k),setItem:(k,v)=>localStorage.setItem(k,v)});
function showCamera(){const labels={top:'TOP of workspace · looking down +Z · X right, Y up',front:'FRONT of workspace · X right, Z up',side:'SIDE of workspace · −Y right, Z up',custom:'CUSTOM orbit'};$('camera-status').textContent=labels[camera.presetName()]+' · roll '+Math.round(camera.roll*180/Math.PI)+'° · hub axes follow IMU';}
for(const name of ['front','top','side'])$('view-'+name).onclick=()=>{camera.preset(name);showCamera();};
$('roll-left').onclick=()=>{camera.rotateRoll(-Math.PI/12);camera.save();showCamera();};$('roll-right').onclick=()=>{camera.rotateRoll(Math.PI/12);camera.save();showCamera();};
$('view-reset').onclick=()=>{camera.reset();viewZoom.fit();showZoom();showCamera();};showCamera();
function showZoom(){$('zoom-value').textContent='View: '+Math.round(viewZoom.factor*100)+'%';$('zoom-percent').value=Math.round(viewZoom.factor*100);}
$('zoom-percent').onchange=()=>{viewZoom.set(Number($('zoom-percent').value)/100);showZoom();};
$('zoom-in').onclick=()=>{viewZoom.change(1.25);showZoom();};$('zoom-out').onclick=()=>{viewZoom.change(.8);showZoom();};$('zoom-fit').onclick=()=>{viewZoom.fit();camera.reset();showZoom();showCamera();};showZoom();
const workspace=new HandWorkspace({getItem:k=>localStorage.getItem(k),setItem:(k,v)=>localStorage.setItem(k,v)});
function showWorkspace(){ $('workspace-unit').value=workspace.unit;workspace.values().forEach((v,i)=>$('workspace-'+'xyz'[i]).value=Number(v.toPrecision(8)));$('workspace-status').textContent='Saved display bounds: '+workspace.values().map(v=>Number(v.toPrecision(5))).join(' × ')+' '+workspace.unit;}
$('workspace-unit').onchange=()=>{const unit=$('workspace-unit').value;workspace.values(unit).forEach((v,i)=>$('workspace-'+'xyz'[i]).value=Number(v.toPrecision(8)));};
$('workspace-apply').onclick=()=>{try{workspace.set([... 'xyz'].map(a=>Number($('workspace-'+a).value)),$('workspace-unit').value);showWorkspace();}catch(e){$('workspace-status').textContent=e.message;}};
$('workspace-reset').onclick=()=>{workspace.reset();showWorkspace();};showWorkspace();

$('hub-mode').value=movementMode.mode;
$('hub-mode').onchange=()=>{movementMode.select($('hub-mode').value);translation.reset();hubPosition=[0,0,0];$('movement').textContent=movementMode.mode==='centered'?'Centered · rotation only':'Hold still for 1 second to initialize movement';$('hub-position').textContent='XYZ: 0 / 0 / 0 cm';};
function profileFor(p){return state.diagnostics?.glove_profiles?.[p?.model_port]?.file||'no-profile';}
function orientationProfile(p){return profileFor(p)+'|source='+sourceFrame.key();}
function measuredDisplayRotation(p){return p.anatomical?p.display_rotation:sourceFrame.rotation(p.display_rotation);}
function displayPosition(port,p){if(p.anatomical)return zReflection.position(port,p.hub_relative_position_m);return sourceFrame.position(displaySettings.position(port,profileFor(p),p.hub_relative_position_m));}
function displayRotation(port,p){const raw=p.anatomical?p.display_rotation:fingerAlignment.apply(port,orientationProfile(p),measuredDisplayRotation(p));return zReflection.rotation(port,raw);}
function showSource(){const names=['X','Y','Z'];$('source-status').textContent='Source frame: '+sourceFrame.rotationMatrix.map((row,i)=>names[i]+' ← '+(row.find(v=>v!==0)<0?'−':'+')+names[row.findIndex(v=>v!==0)]).join(' · ')+' · PCB offsets are saved separately for each source alignment';}
for(const axis of ['X','Y','Z'])$('source-'+axis.toLowerCase()).onclick=()=>{sourceFrame.turn(axis);orientationHistory={};showSource();renderPorts();};
$('source-reset').onclick=()=>{sourceFrame.reset();orientationHistory={};showSource();renderPorts();};showSource();
$('backup-setup').onclick=()=>{const settings={};for(let i=0;i<localStorage.length;i++){const key=localStorage.key(i);if(key.startsWith('6thsense.')||key.startsWith('glove-'))settings[key]=localStorage.getItem(key);}const backup={saved:new Date().toISOString(),settings,lastDisplayedPoses:poses,loadedProfiles:state.diagnostics?.glove_profiles||{},sourceFrame:sourceFrame.rotationMatrix};const url=URL.createObjectURL(new Blob([JSON.stringify(backup,null,2)],{type:'application/json'})),link=document.createElement('a');link.href=url;link.download='glove-setup-backup-'+Date.now()+'.json';link.click();setTimeout(()=>URL.revokeObjectURL(url),3000);text('Setup backup downloaded. No settings changed.');};
const headers={'Content-Type':'application/json','X-Control-Token':token};
async function action(name,data={}){const r=await fetch('/api/action',{method:'POST',headers,body:JSON.stringify({action:name,...data})});const s=await r.json();if(!r.ok)throw Error(s.error||'Hub request failed');state=s;return s;}
function text(message){$('status').textContent=message;}
const delay=ms=>new Promise(resolve=>setTimeout(resolve,ms));
async function halt(){running=false;stopping=true;$('stop').disabled=true;try{await fetch('/api/stop',{method:'POST',headers});}catch{} }
async function start(){if(running||stopping)return;running=true;$('start').disabled=true;$('stop').disabled=false;poses={};rangeBaselines={};poseAt=0;imuAt=0;lastCapture=0;imuCount=0;groupIndex=0;captureFault='';
orientation.q=[1,0,0,0];orientation.last=null;orientation.initialized=false;translation.reset();lastImuId=null;orientationHistory={};approachCheck.reference=null;hubPosition=[0,0,0];hubRotation=identity;
try{ text('Connecting and loading saved fingertip calibration…');await action('connect');if(!running)return;await action('power_on');await action('probe');detectedMask=state.status.found||0;await action('hand_load');const flat=new HandOrientation().update(state.diagnostics.hand_reference.reference_accel.map(v=>v/4096),[0,0,0],performance.now()).matrix;imuMount=flat[0].map((_,i)=>flat.map(row=>row[i]));$('source-x').closest('details').hidden=true;const loaded=Object.entries(state.diagnostics.glove_profiles||{});$('profiles').textContent=loaded.length?'Saved calibration loaded: '+loaded.map(([port,p])=>`J${port} (${p.file})`).join(', '):'No compatible saved profile: '+(state.diagnostics.glove_profile_errors||[]).map(e=>e.reason).join('; ');await action('imu_on');interval=['0.2.6-diagnostics','0.2.7-diagnostics'].includes(state.status.firmware)?1000/60:state.status.firmware==='0.2.5-diagnostics'?350:2300;captures=0;await delay(2100);session=performance.now();
while(running){const now=performance.now();let frameImu=false;if(document.hidden||now-session>120000){text('Session paused. Press Start to continue.');break;}
 if(now-lastCapture>=interval){const found=state.status.found||0;if(found){const groups=handCaptureGroups(found),selectedMask=interval<20?groups[groupIndex++%groups.length]:found;await action(interval<20?'hand_frame':interval===350?'capture_track':'capture_tx',{mask:selectedMask,axes:7,bench_ready:true});captures++;frameImu=interval<20;if(!running)break;if(!frameImu)await action('glove_solve');poseAt=performance.now();for(const [port,pose] of Object.entries(state.diagnostics.glove_poses||{})){poses[port]={...pose,receivedAt:poseAt};if(pose.display_rotation&&!pose.error)orientationHistory[port]=[...(orientationHistory[port]||[]),{time:poseAt,rotation:measuredDisplayRotation(pose)}].filter(v=>poseAt-v.time<800).slice(-24);else orientationHistory[port]=[];}}lastCapture=now;if(now-panelAt>150&&!settingsOpen.size&&!alignmentOpen.size){renderPorts();panelAt=now;}}
 if(!running)break;
 if(!frameImu){if(interval<20&&state.status.found){await delay(Math.max(1,interval-(performance.now()-lastCapture)));continue;}await action('imu_read');}const line=state.diagnostics.imu_read.reply,m=/IMU accel=(-?\d+),(-?\d+),(-?\d+) gyro=(-?\d+),(-?\d+),(-?\d+)/.exec(line);
 if(!m)throw Error('Unrecognized IMU reading');const a=m.slice(1,4).map(Number).map(x=>x/4096),g=m.slice(4,7).map(Number).map(x=>x*2000/32768);const sampleTime=performance.now(),sampleId=/time=(\d+)/.exec(line)?.[1];const fresh=sampleId!==undefined&&sampleId!==lastImuId;const correctedGyro=g.map((v,i)=>v-translation.gyroBias[i]);const estimate=fresh?orientation.update(a,correctedGyro,sampleTime,movementMode.mode==='centered'||!translation.ready||translation.rest>=.6):{matrix:hubRotation,valid:false};hubRotation=fresh?estimate.matrix.map(row=>imuMount[0].map((_,j)=>row.reduce((sum,v,k)=>sum+v*imuMount[k][j],0))):hubRotation;imuAt=estimate.valid?performance.now():0;if(fresh){imuCount++;lastImuId=sampleId;}const movement=movementMode.mode==='moving'?translation.update(a,g,estimate.matrix,sampleTime,sampleId):{position:[0,0,0],velocity:[0,0,0],acceleration:[0,0,0],ready:true,status:'Centered · rotation only; movement estimation off'};hubPosition=movementMode.position(movement.position);$('movement').textContent=movement.status;$('hub-position').textContent=movementMode.mode==='centered'?'XYZ: centered (translation off)':movement.ready?'Estimated XYZ: '+hubPosition.map(v=>(v*100).toFixed(1)).join(' / ')+' cm':'Estimated XYZ: awaiting still initialization';$('hub-motion').textContent=movementMode.mode==='centered'?'Movement estimation disabled':'Linear acceleration: '+movement.acceleration.map(v=>v.toFixed(2)).join(' / ')+' m/s² · speed '+(Math.hypot(...movement.velocity)*100).toFixed(1)+' cm/s';
 const r=hubRotation;const roll=Math.atan2(r[2][1],r[2][2])*180/Math.PI,pitch=Math.asin(Math.max(-1,Math.min(1,-r[2][0])))*180/Math.PI,yaw=Math.atan2(r[1][0],r[0][0])*180/Math.PI;
 $('imu').textContent=`${roll.toFixed(0)}° / ${pitch.toFixed(0)}° / ${yaw.toFixed(0)}°`;
 $('imu').title='Roll / pitch / relative yaw';
 text(`Running · ${Object.values(poses).filter(p=>p.hub_relative_position_m).length} tracked fingertip(s) · ${Math.ceil((120000-(performance.now()-session))/1000)} s left`);
 $('rate').textContent=`IMU ${(imuCount*1000/(performance.now()-session)).toFixed(1)} updates/s · capture bursts ${(captures*1000/(performance.now()-session)).toFixed(1)} updates/s${interval<20?' · staggered receivers, '+handCaptureGroups(detectedMask).length+' groups':interval===350?'':' · firmware update needed for faster mode'}`;
 await delay(interval<20?Math.max(0,interval-(performance.now()-now)):35);
}
}catch(e){captureFault=e.message;if(!imuCount)$('imu').textContent='No IMU frame: capture stopped';text(e.message.includes('drdy_overrun')?'Acquisition stopped: receiver data overrun. No fresh finger or combined IMU frame.':e.message);}finally{running=false;stopping=true;await fetch('/api/stop',{method:'POST',headers}).catch(()=>{});await action('power_off').catch(()=>{});stopping=false;$('start').disabled=false;$('stop').disabled=true;renderPorts();}}
$('start').onclick=start;$('stop').onclick=()=>{text('Paused. Press Start to continue.');halt();};$('zero').onclick=()=>{orientation.zeroHeading();translation.reset();hubPosition=[0,0,0];$('movement').textContent='Hold still briefly to recenter';$('hub-position').textContent='Estimated XYZ: awaiting still initialization';$('hub-motion').textContent='Linear acceleration / speed: zeroing';};document.addEventListener('visibilitychange',()=>{if(document.hidden&&running)halt();});window.addEventListener('pagehide',()=>{if(running||stopping)fetch('/api/stop',{method:'POST',headers,keepalive:true}).catch(()=>{});});
function directionControls(port,p){
 const profile=profileFor(p),s=displaySettings.get(port,profile),box=document.createElement('details');box.open=settingsOpen.has(port);
 box.ontoggle=()=>{if(box.open)settingsOpen.add(port);else settingsOpen.delete(port);};
 const summary=document.createElement('summary');summary.textContent='Adjust movement direction';summary.style.cssText='cursor:pointer;margin-top:12px';box.append(summary);
 const note=document.createElement('small');note.textContent='Position only, relative to hub. Rotation triads stay measured. Saved for this port and profile.';box.append(note);
 for(let axis=0;axis<3;axis++){
  const row=document.createElement('div');row.style.cssText='display:flex;gap:8px;align-items:center;margin-top:8px';
  const label=document.createElement('label');label.textContent='Display '+'XYZ'[axis]+' from ';const select=document.createElement('select');select.setAttribute('aria-label',`J${port} display ${'XYZ'[axis]} source axis`);
  for(let input=0;input<3;input++){const option=document.createElement('option');option.value=input;option.textContent='XYZ'[input];select.append(option);}select.value=s.axes[axis];
  select.onchange=()=>{displaySettings.axis(port,profile,axis,Number(select.value));renderPorts();};label.append(select);row.append(label);
  const reverse=document.createElement('button');reverse.className='secondary';reverse.style.cssText='padding:6px 9px;font-size:12px';reverse.textContent=s.signs[axis]<0?'Reversed':'Normal';reverse.setAttribute('aria-label',`J${port} reverse ${'XYZ'[axis]} direction`);reverse.setAttribute('aria-pressed',String(s.signs[axis]<0));reverse.onclick=()=>{displaySettings.reverse(port,profile,axis);renderPorts();};row.append(reverse);box.append(row);
 }
 const reset=document.createElement('button');reset.className='secondary';reset.textContent='Reset directions';reset.style.cssText='padding:6px 9px;margin-top:8px';reset.onclick=()=>{displaySettings.reset(port,profile);renderPorts();};box.append(reset);
 const feedback=document.createElement('small');feedback.textContent=displaySettings.error||'Position-only override (not PCB orientation) · '+s.axes.map((a,i)=>'XYZ'[i]+' ← '+(s.signs[i]<0?'−':'+')+'XYZ'[a]).join(' · ');box.append(feedback);return box;
}
function alignmentControls(port,p){
 const profile=orientationProfile(p),record=fingerAlignment.get(port,profile),box=document.createElement('details');box.open=alignmentOpen.has(port);box.ontoggle=()=>{if(box.open)alignmentOpen.add(port);else alignmentOpen.delete(port);};
 const summary=document.createElement('summary');summary.textContent='Align PCB orientation';summary.style.cssText='cursor:pointer;margin-top:12px';box.append(summary);
 const note=document.createElement('small');note.textContent='Reference is relative to the transmitter frame: keep hub/source level, component side up, and point this fingertip’s flex tail forward (+Y). This stores a mounting offset, not a new magnetic calibration.';box.append(note);
 const label=document.createElement('label'),confirm=document.createElement('input');confirm.type='checkbox';confirm.setAttribute('aria-label',`J${port} reference pose confirmed`);label.append(confirm,document.createTextNode(' This finger and hub/source are in the reference pose'));box.append(label);
 const message=document.createElement('small');message.setAttribute('role','status');
 function current(){const pose=poses[port];if(!running||!pose?.display_rotation||pose.error||performance.now()-pose.receivedAt>250)throw Error('Start live view and wait for a fresh valid orientation.');return pose;}
 const capture=document.createElement('button');capture.className='secondary';capture.textContent='Save flat reference';capture.style.cssText='padding:8px;margin-top:8px';capture.onclick=()=>{try{current();fingerAlignment.align(port,profile,orientationHistory[port]||[],confirm.checked);message.textContent=fingerAlignment.error||'Flat reference saved. Now check both lift directions below.';confirm.checked=false;}catch(e){message.textContent=e.message;}};box.append(capture);
 const instructions=document.createElement('small');instructions.textContent='Keep hub/source still. Lift the tail to 90° about the PCB right axis, check it; return flat. Then lift the right edge to 90° about the tail axis, and check. A failed check means orientation is not validated.';box.append(instructions);
 for(const [axis,title] of [['tail','Check tail lifted 90°'],['right','Check right edge lifted 90°']]){const button=document.createElement('button');button.className='secondary';button.textContent=title;button.style.cssText='padding:8px;margin-top:6px';button.onclick=()=>{try{const result=fingerAlignment.check(port,profile,measuredDisplayRotation(current()),axis);message.textContent=(result.passed?'Check passed':'Check failed')+': '+result.error_degrees.toFixed(1)+'° difference. '+(result.passed?'This validates only this reference direction.':'Do not treat this as a calibrated PCB orientation.');}catch(e){message.textContent=e.message;}};box.append(button);}
 const reset=document.createElement('button');reset.className='secondary';reset.textContent='Remove orientation offset';reset.style.cssText='padding:8px;margin-top:6px';reset.onclick=()=>{fingerAlignment.reset(port,profile);message.textContent='Offset removed; showing calibration-start orientation.';};box.append(reset);
 message.textContent=record?'Flat offset saved · '+Object.entries(record.checks||{}).map(([axis,c])=>axis+': '+(c.passed?'passed':'failed')).join(' · '):'No PCB mounting reference saved for this port/profile.';box.append(message);return box;
}
const approachCheck=new HandApproachCheck();
function approachPositions(){const port=$('approach-moving').value,target=$('approach-target').value;for(const id of [port,target]){const p=poses[id];if(!running||!p?.hub_relative_position_m||p.error||performance.now()-p.receivedAt>250)throw Error('Both selected ports need fresh valid tracking.');}return {port,target,a:poses[port].hub_relative_position_m,b:poses[target].hub_relative_position_m};}
$('approach-start').onclick=()=>{try{const p=approachPositions();approachCheck.start(p.port,p.target,p.a,p.b);$('approach-status').textContent='Start recorded. Now move only J'+p.port+' closer to J'+p.target+', keeping orientation unchanged.';}catch(e){$('approach-status').textContent=e.message;}};
$('approach-check').onclick=()=>{try{const p=approachPositions(),r=approachCheck.finish(p.port,p.target,p.a,p.b);$('approach-status').textContent=r.result+'. Model distance: '+r.normal.map(v=>(100*v).toFixed(1)).join(' → ')+' cm; opposite branch: '+r.mirror.map(v=>(100*v).toFixed(1)).join(' → ')+' cm. '+(r.result.startsWith('opposite')?'Use Flip side on J'+p.port+' and repeat to verify.':'No settings changed.');}catch(e){$('approach-status').textContent=e.message;}};
function renderPorts(){const root=$('ports');root.replaceChildren();for(let i=1;i<=5;i++){const connected=!!(detectedMask&(1<<(i-1))),p=poses[i],div=document.createElement('div');div.className='port'+(connected?' live':'');const title=document.createElement('strong');title.textContent=`J${i}${({1:' · Thumb (right hand)',2:' · Index',5:' · Pinky'})[i]||''} · ${connected?'Detected':'Not detected'}`;const detail=document.createElement('small');if(p?.error){detail.textContent=p.error;div.append(title,detail);}else if(p?.hub_relative_position_m){const v=displayPosition(i,p).map(x=>(100*x).toFixed(1));detail.textContent=`${running?'':'Last: '}X ${v[0]} · Y ${v[1]} · Z ${v[2]} cm`;const info=document.createElement('small');info.textContent=`${p.anatomical?(p.shared_model?'Shared fit · ':'Own fit · ')+(p.metric?'reference-scaled · ':'estimated scale · '):(p.provisional?'Shared receiver model · ':'Saved receiver model · ')}Model residual ${(p.relative_residual*100).toFixed(1)}% · ${p.anatomical?(p.mount_registered?'flat-hand mounting reference':'mounting unregistered'):(fingerAlignment.get(i,orientationProfile(p))?'PCB reference aligned':'orientation unaligned (calibration-start frame)')}`;div.append(title,detail,info);}else {detail.textContent=connected?(captureFault?'Capture stopped: '+captureFault:'Waiting for a valid magnetic measurement'):'Attach with USB unplugged';div.append(title,detail);}if(p?.signal){const bars=document.createElement('div');bars.style.cssText='display:flex;gap:4px;height:30px;align-items:flex-end;margin-top:10px';const strengths=p.signal.tone_strength_counts;for(let t=0;t<3;t++){const bar=document.createElement('span');bar.style.cssText=`flex:1;background:${p.provisional?'#d6aa64':'#75ba98'};height:${Math.max(2,Math.min(30,Math.log10(1+strengths[t])*7))}px`;bar.title=`${'XYZ'[t]} transmitter: ${strengths[t].toFixed(1)} counts`;bars.append(bar);}div.append(bars);const strength=document.createElement('small');strength.textContent=`X / Y / Z signal: ${strengths.map(v=>v.toFixed(0)).join(' / ')} counts`;div.append(strength);if(p.provisional&&!p.signal.clipped&&Math.min(...strengths)>5){const total=p.signal.total_counts;if(!rangeBaselines[i])rangeBaselines[i]=total;const range=document.createElement('small');range.textContent=`Range proxy: ${(100*Math.cbrt(rangeBaselines[i]/total)).toFixed(0)}% of start · keep orientation fixed`;div.append(range);}}if(p?.hub_relative_position_m){const flip=document.createElement('button');flip.className='secondary';flip.textContent='Invert XYZ (mirror)';flip.style.cssText='padding:6px 10px;margin-top:8px;font-size:12px';flip.title='Switch all three position signs; use Reverse Z for height only';flip.onclick=async()=>{try{await action('hand_flip',{sensor:i});}catch(e){text(e.message);}};div.append(flip);const stable=document.createElement('small');stable.textContent=p.branch_reacquired_after_gap?'Signal recovered · check side; use Flip side if mirrored':'Motion-aware smoothing · continuous side tracking';div.append(stable);}if(connected&&p?.hub_relative_position_m&&!p.anatomical){div.append(directionControls(i,p));div.append(alignmentControls(i,p));}if(connected){const l=document.createElement('label'),c=document.createElement('input');c.type='checkbox';c.checked=zReflection.enabled(i);c.setAttribute('aria-label',`J${i} reverse Z only`);c.onchange=()=>{zReflection.set(i,c.checked);showZ();};l.append(c,' Reverse height (Z only)');div.append(l);}root.append(div);}}
const canvas=$('space'),ctx=canvas.getContext('2d');const mul=(m,v)=>m.map(row=>row.reduce((s,x,i)=>s+x*v[i],0)), add=(a,b)=>a.map((v,i)=>v+b[i]);
canvas.addEventListener('wheel',event=>{event.preventDefault();const pixels=event.deltaY*(event.deltaMode===1?16:event.deltaMode===2?300:1);viewZoom.change(Math.exp(-Math.max(-200,Math.min(200,pixels))*.002));showZoom();},{passive:false});
let cameraDrag=null;
canvas.style.touchAction='none';canvas.style.cursor='grab';
canvas.addEventListener('contextmenu',e=>e.preventDefault());
canvas.addEventListener('pointerdown',e=>{if(![0,2].includes(e.button))return;e.preventDefault();cameraDrag={id:e.pointerId,x:e.clientX,y:e.clientY,mode:e.button===2||e.shiftKey?'pan':e.altKey?'roll':'orbit'};canvas.setPointerCapture(e.pointerId);canvas.style.cursor='grabbing';});
canvas.addEventListener('pointermove',e=>{if(!cameraDrag||cameraDrag.id!==e.pointerId)return;const dx=e.clientX-cameraDrag.x,dy=e.clientY-cameraDrag.y,rect=canvas.getBoundingClientRect();if(cameraDrag.mode==='pan')camera.move(dx,dy,rect.width,rect.height);else if(cameraDrag.mode==='roll')camera.rotateRoll(dx*.006);else camera.orbit(dx,dy);cameraDrag.x=e.clientX;cameraDrag.y=e.clientY;showCamera();});
function endCameraDrag(e){if(cameraDrag?.id!==e.pointerId)return;cameraDrag=null;if(canvas.hasPointerCapture(e.pointerId))canvas.releasePointerCapture(e.pointerId);canvas.style.cursor='grab';camera.save();}
canvas.addEventListener('pointerup',endCameraDrag);canvas.addEventListener('pointercancel',endCameraDrag);
function frame(){const rect=canvas.getBoundingClientRect(),dpr=devicePixelRatio||1;if(canvas.width!==Math.round(rect.width*dpr)||canvas.height!==Math.round(rect.height*dpr)){canvas.width=Math.round(rect.width*dpr);canvas.height=Math.round(rect.height*dpr);}ctx.setTransform(dpr,0,0,dpr,0,0);const w=rect.width,h=rect.height;ctx.clearRect(0,0,w,h);
 const sceneScale=Math.min(w,h)*.75/Math.hypot(...workspace.metres)*viewZoom.factor;
 const project=p=>camera.project(p,w,h,sceneScale);
 const line=(a,b,color,width=1)=>{ctx.strokeStyle=color;ctx.lineWidth=width;ctx.beginPath();ctx.moveTo(...project(a));ctx.lineTo(...project(b));ctx.stroke();};
 const label=(p,t,c='#c7dbcf')=>{ctx.fillStyle=c;ctx.font='12px system-ui';const q=project(p);ctx.fillText(t,q[0]+8,q[1]-8);};
 const [wx,wy,wz]=workspace.metres;
 for(let i=-5;i<=5;i++){line([i*wx/10,-wy/2,0],[i*wx/10,wy/2,0],'#2b3c33');line([-wx/2,i*wy/10,0],[wx/2,i*wy/10,0],'#2b3c33');}
 const bounds=Array.from({length:8},(_,i)=>[(i&1?1:-1)*wx/2,(i&2?1:-1)*wy/2,(i&4?1:-1)*wz/2]);for(let i=0;i<8;i++)for(const bit of [1,2,4])if(!(i&bit))line(bounds[i],bounds[i|bit],'#3e5448');
 $('grid-size').textContent='Grid: '+workspace.values().slice(0,2).map(v=>Number((v/10).toPrecision(3))).join(' × ')+' '+workspace.unit;

 const current=performance.now(),imuFresh=running&&current-imuAt<1000,poseFresh=running&&current-poseAt<Math.max(250,interval*2);
 const {position:renderPosition,rotation:renderRotation}=handViewTransform(viewFrame,hubPosition,hubRotation);
 const transform=p=>composeHandPoint(renderPosition,renderRotation,p);const corners=[[-.025,-.02,0],[.025,-.02,0],[.025,.02,0],[-.025,.02,0]].map(transform);ctx.beginPath();corners.forEach((p,i)=>{const v=project(p);i?ctx.lineTo(...v):ctx.moveTo(...v)});ctx.closePath();ctx.fillStyle=$('robot-overlay').checked?'rgba(82,142,112,.12)':imuFresh?'#528e70':'#414a45';ctx.fill();ctx.strokeStyle='#a9d8ba';ctx.stroke();label(renderPosition,imuFresh?(movementMode.mode==='centered'?'HUB · CENTERED':'HUB · ESTIMATED MOVEMENT'):'HUB · paused / stale');
 const colors=['#e99c95','#a6dca2','#88bbef'];for(let axis=0;axis<3;axis++){const v=[0,0,0];v[axis]=.065;line(renderPosition,transform(v),colors[axis],2);label(transform(v),'Hub '+'XYZ'[axis],colors[axis]);}
 const cadPoses={};if(running)for(const [port,p]of Object.entries(poses))cadPoses[port]=p.hub_relative_position_m&&p.display_rotation?zReflection.pose(port,p):p;
 if(window.aeroCad)window.aeroCad.update({enabled:$('robot-overlay').checked,poses:cadPoses,detected:detectedMask,hubPosition:renderPosition,hubRotation:renderRotation,camera,width:w,height:h,scale:sceneScale,state,now:current});
 if(poseFresh){for(const [port,p]of Object.entries(poses)){if(p.error||!p.hub_relative_position_m||current-(p.receivedAt||0)>=Math.max(250,interval*2))continue;const point=transform(displayPosition(port,p));line(renderPosition,point,'#557766',1);const q=project(point);ctx.fillStyle=p.provisional?'#efbd73':'#c4f5d9';ctx.beginPath();ctx.arc(...q,7,0,Math.PI*2);ctx.fill();label(point,`J${port}${p.shared_model?' shared model':p.anatomical&&!p.metric?' estimated scale':''} · ${(Math.hypot(...p.hub_relative_position_m)*100).toFixed(1)} cm`);if(p.display_rotation){for(let axis=0;axis<3;axis++){const v=[0,0,0];v[axis]=.022;line(point,add(point,mul(renderRotation,mul(displayRotation(port,p),v))),colors[axis],2);}}}}
 // Fixed screen compass shows scene axes independently of hub orientation.
 const cue=[w-65,75];ctx.font='11px system-ui';ctx.fillStyle='#a8b9af';ctx.fillText('Scene XYZ',w-105,28);
 for(let axis=0;axis<3;axis++){const v=[0,0,0];v[axis]=1;const d=camera.vector(v);ctx.strokeStyle=colors[axis];ctx.lineWidth=2;ctx.beginPath();ctx.moveTo(...cue);ctx.lineTo(cue[0]+d[0]*34,cue[1]-d[1]*34);ctx.stroke();ctx.fillStyle=colors[axis];ctx.fillText('XYZ'[axis],cue[0]+d[0]*42,cue[1]-d[1]*42);}
 $('badge').textContent=running&&!workspace.contains(hubPosition)?'HUB ESTIMATE OUTSIDE DISPLAY BOUNDS':running?`LIVE · ${poseFresh&&Object.values(poses).some(p=>p.hub_relative_position_m)?(viewFrame==='hand'?'HAND AXES · HUB FIXED':'SESSION TRACKING'):'WAITING FOR VALID POSITION'}${imuFresh?' + IMU':''}`:'PAUSED · OUTPUTS OFF';requestAnimationFrame(frame);}
renderPorts();frame();
