6thSense-dev/mocap-glove/control-panel/axis-guide.js

'use strict';
(()=>{let stage=0,groups={},guideBusy=false,port=2;const names=['start','x','y','z'];const messages=[
'Keep the hub fixed. Hold J2 at a comfortable starting position, with its orientation steady. Click Record starting position when ready.',
'From that same starting position, move only the receiver about 3–5 cm RIGHT (+X). Keep the hub fixed and receiver facing the same way. Hold it still, then record.',
'Return the receiver to its starting position, then move it about 3–5 cm FORWARD (+Y, toward the fingertips). Keep the hub fixed and receiver orientation unchanged. Hold still, then record.',
'Return to the starting position, then move the receiver about 3–5 cm UP (+Z, away from the back-of-hand plane). Keep the hub fixed and receiver orientation unchanged. Hold still, then record.'
];function show(){$('axis-instruction').textContent=messages[stage]?.replace('J2','J'+$('axis-port').value)||'All four poses saved.';$('axis-record').textContent=stage===0?'Record starting position':'Record +'+names[stage]?.toUpperCase()+' position';$('axis-record').disabled=guideBusy||stage>3;$('axis-port').disabled=guideBusy||stage>0;}
$('axis-port').onchange=show;show();$('axis-restart').onclick=()=>{if(guideBusy)return;stage=0;groups={};show();$('axis-result').textContent='Ready for a new start. Previous calibration remains saved.';};
$('axis-record').onclick=async()=>{if(guideBusy)return;guideBusy=true;show();try{if(running){await halt();for(let i=0;i<60&&stopping;i++)await delay(100);if(stopping)throw Error('Wait for live tracking to stop');}port=Number($('axis-port').value);await action('connect');await action('power_on');await action('probe');if(!(state.status.found&(1<<(port-1))))throw Error('J'+port+' is not detected');await action('hand_load');await action('imu_on');await delay(2100);const files=[];$('axis-result').textContent='Recording a stationary snapshot… keep the hub and receiver still.';for(let i=0;i<4;i++){if(document.hidden)throw Error('Keep this page visible');await action('capture_track',{mask:1<<(port-1),axes:7,bench_ready:true});files.push(state.capture.file);$('axis-result').textContent='Captured '+(i+1)+' of 4 samples.';await delay(450);}groups[names[stage]]=files;localStorage.setItem('6thsense.axis-guide-recording',JSON.stringify({port,groups,saved:new Date().toISOString()}));await action('power_off');stage++;if(stage===4){$('axis-result').textContent='Checking the measured movement directions…';await action('axis_fit',{sensor:port,groups});const fit=state.diagnostics.axis_fit;$('axis-result').textContent='Axis mapping saved. Direction-fit errors: '+fit.direction_error_deg.map(v=>v.toFixed(1)+'°').join(' / ')+'. Original calibration preserved. Start tracking in Hand-relative view, then repeat a small right/forward/up move to verify.';}else $('axis-result').textContent='Saved. Outputs off. Follow the next instruction above.';}catch(e){$('axis-result').textContent='Not accepted: '+e.message;}finally{await action('power_off').catch(()=>{});guideBusy=false;show();}};
})();
