6thSense-dev/mocap-glove/(commit log)

2026-11-02 Add magnetic glove firmware and tracking viewer with Aero Hand visualization
2026-11-04 Add complete V6 PCB projects and manufacturing archive
    [BOM.csv, controller.kicad_sch, finger-interfaces.kicad_sch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]
